EnesCanbolat/EE463-Project/An example of expected design.jpeg

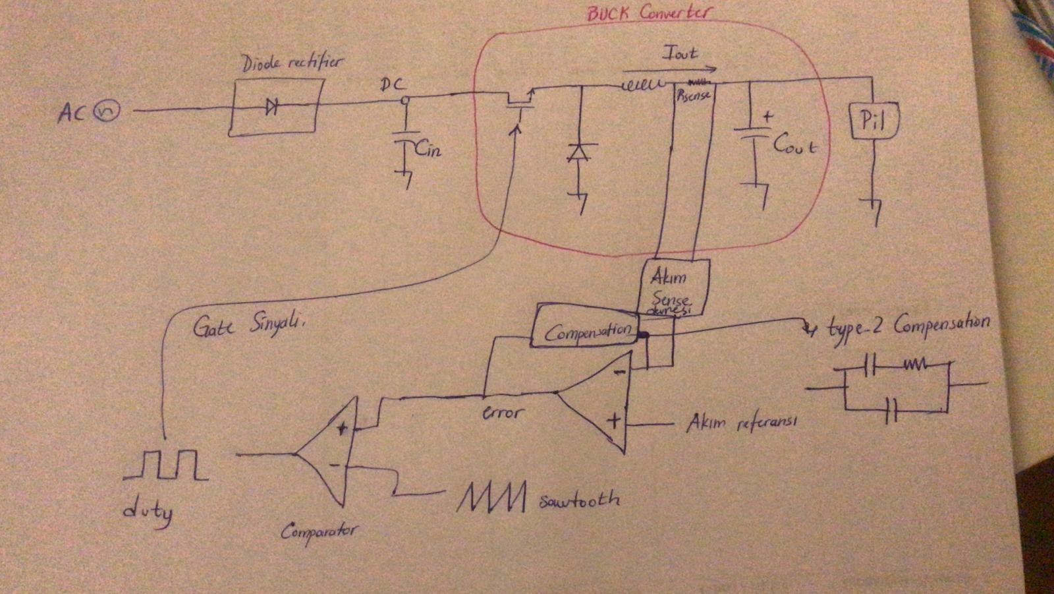
An example of expected design.jpeg
