EnesCanbolat/EE463-Project/pcb design/3D_1.JPG

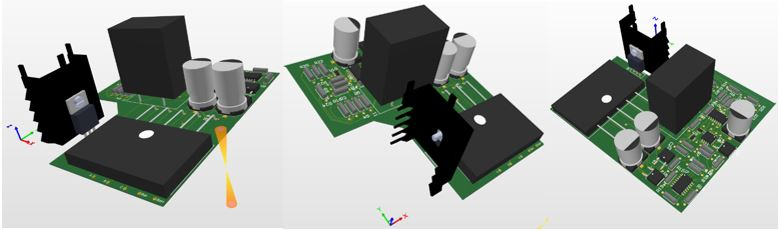
pcb design/3D_1.JPG
