EnesCanbolat/EE463-Project/Report Versions/EE463_Term_Project_Report_Kardesler_Elektronik_Berkay_Emin_Enes.docx

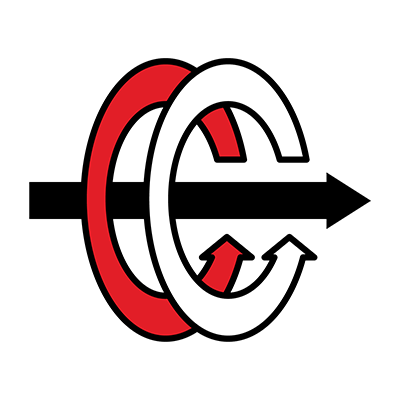
[picture p5: figure]

MIDDLE EAST TECHNICAL UNIVERSITY

ELECTRICAL & ELECTRONICS ENGINEERING

EE463 – STATIC POWER CONVERSION 1

TERM PROJECT – COMPLETE SIMULATION REPORT

Emin ÜN 2167476

Enes CANBOLAT 2231546

Berkay UZUN 2263812

25.12.2020

# 1- INTRODUCTION

Renewable energy is defined as useful energy collected from renewable resources. The wind is one of the renewable resources. It is used to provide mechanical power to the wind turbines to generate electricity. Wind power is widely used in sustainable energy. However, there are some problems with using the electricity produced in wind turbines. These turbines, generally, behave like an electric generator with a continuously varying output voltage and output current. In this project, Kardesler Elektronik A.Ş. introduces AC to the DC Converter project which regulates the output current. In the first part of this report, the topology of the converter will be discussed. The advantages and disadvantages of different topologies will be compared. Moreover, the reason for the topology selection will be given. In the second part, the circuit schematic and its simulation results with ideal cases will be provided. Moreover, the component selection and cost analysis will be provided in the second part. To conclude, our engineering skills in circuit design, simulations, and our project management skills will improve. Additionally, this project will give us an opportunity to implement the theoretical knowledge of us on EE463 lecture.

# 2- TOPOLOGY SELECTION

As mentioned in the 'Introduction' section, the generated voltage needs to be rectified to feed the given battery. To do this rectification, there are some topologies that can be used. Using a 3-phase thyristor rectifier and the diode rectifier with a buck converter are the most common ones. In this project, we preferred the diode rectifier with a buck converter topology because of some reasons. Firstly, controlled the thyristors considering their phase difference is not an easy job; however, the diode rectifier does not need any gate voltage and operates without any external intervention. On the other hand, we need to control the gate voltage of the MOSFET and hence the duty cycle of the buck converter to keep the output current the same. For this operation, again there is no one solution, using integrated circuits (IC) is one of the alternative solutions; however, the operating conditions are very important for these ICs. As shown in the 'Simulation Results' section, the input voltage varies, and this high voltage can damage the selected IC. That's why we preferred to control the gate signal of the MOSFET with an analog circuit design. Moreover, we wanted to observe the feedback operation step by step. If we used an integrated circuit, we would not be able to observe the entire circuit. Due to missing IC models in MATLAB and the modeling problem of input generator and battery in other simulation applications, we wouldn't be able to examine the performance of the design. Because of the pandemic conditions, we have also no chance to physically work on the designed circuit in the laboratory. Considering all these reasons, we decided to design an analog PI controller circuit. The last thing, we need to feed the gate of the MOSFET and hence we used one of the most common PWM generators called 555timer which can also be modeled in MATLAB Simulink. In short, we chose diode rectifiers with a buck converter topology and designed a closed-loop PI feedback controller without using any integrated circuit. In the following section, circuit blocks will be examined in detail and the simulation results will be shown.

# 3- CIRCUIT ANALYSIS & SIMULATION RESULTS

As mentioned before, our circuit design includes some parts and in this section, these blocks are examined in detail. In Figure 1, the block diagram of the circuit design is visualized.

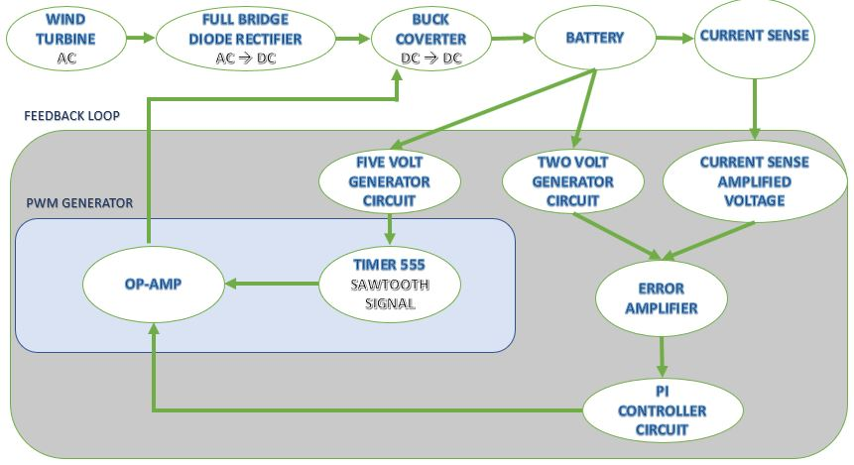
[picture p6: figure]

Figure 1 Block Diagram of the Circuit Design

## 3.1 Diode Rectifier and Buck Converter Block

As we learned in our lectures, a 3-phase diode rectifier is a good method to rectify the given AC signal; however, it is not enough to feed the battery without any external component since the output of the rectifier depends on the input voltage and it is affected by the changes in the input voltages. In the following Figure 2, the input voltage waveforms of the rectifier are illustrated.

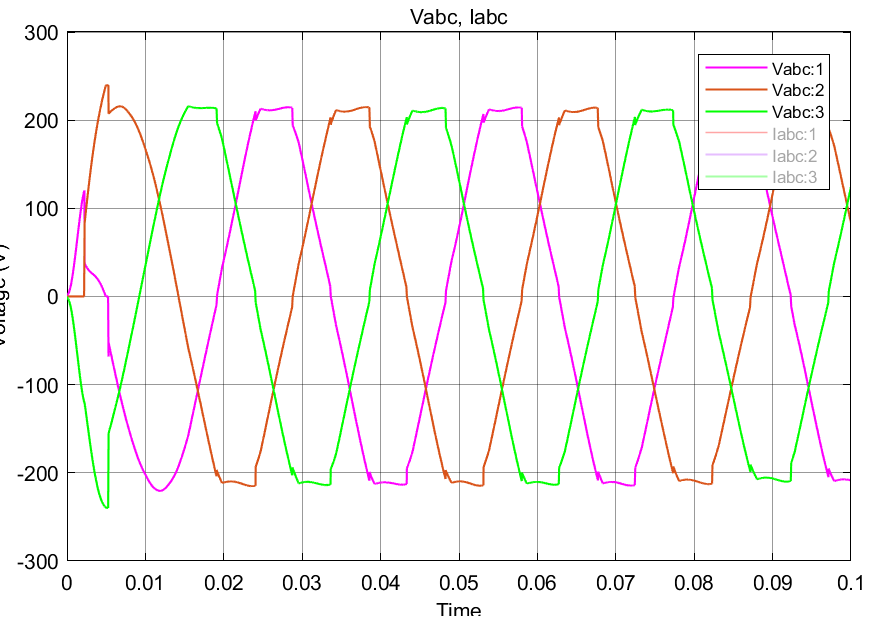
[picture p7: figure]

Figure 2 Input Voltage Waveforms of Diode Rectifier

The output voltage waveform is not a pure DC signal, in other words, the voltage ripple is very high on this waveform. Therefore, we used a shunt capacitor (100µF) to filter this signal. Then, we connected this output to the MOSFET of the buck converter. For the buck converter design 15mH inductor and 100µF capacitor are used. In the following Figure 3, this block of the design is shown, also in the next figure the input currents of the diodes are shown. These current values are important while selecting the proper diode.

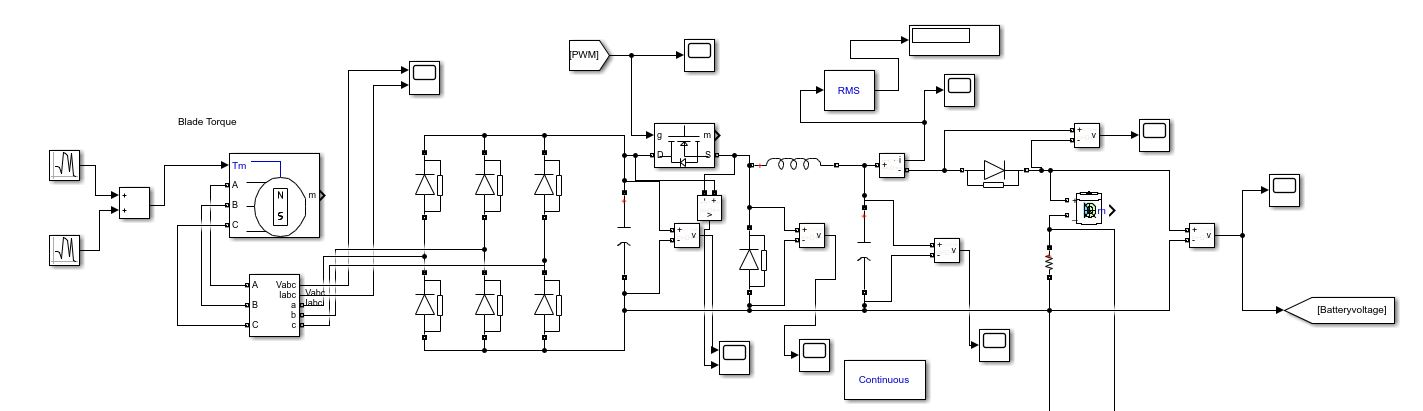
[picture p8: figure]

Figure 3 Diode Rectifier and Buck Converter Block

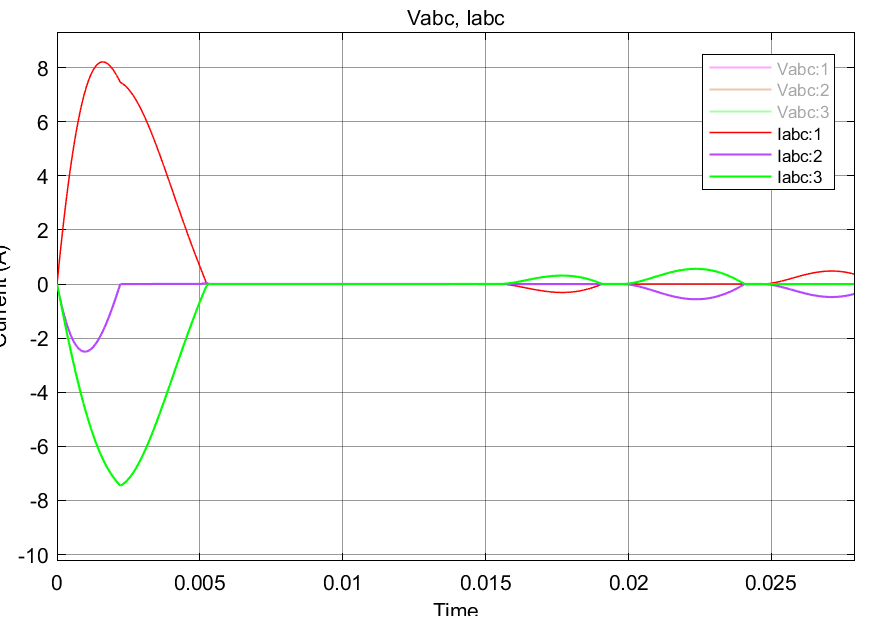
[picture p9: figure]

Figure 4 Input Current Waveforms of Diodes

## 3.2 Current Sense and Amplifier Block

In the project description, the input current value of the battery is given as a constant 2A and the ripple limit is 20% of the average current which is also specified in this description. Not to exceed this limit we connected a small resistor (250mΩ) to the negative leg of the battery. By checking the voltage on this resistor, we can understand the current flow through the resistor and hence the battery, and using this knowledge we can start our feedback loop; however, the resistance and current values are not high enough to decide the error. Therefore, we amplified this voltage value up to 3V and this block and this amplified voltage are shown in Figure 5 and Figure 6, respectively.

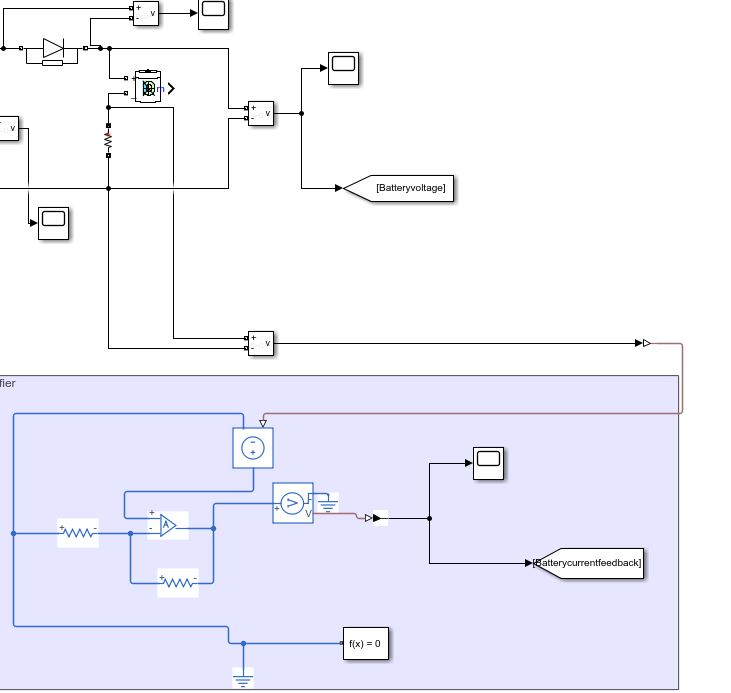
[picture p10: figure]

Figure 5 Current Sense and Amplifier Block

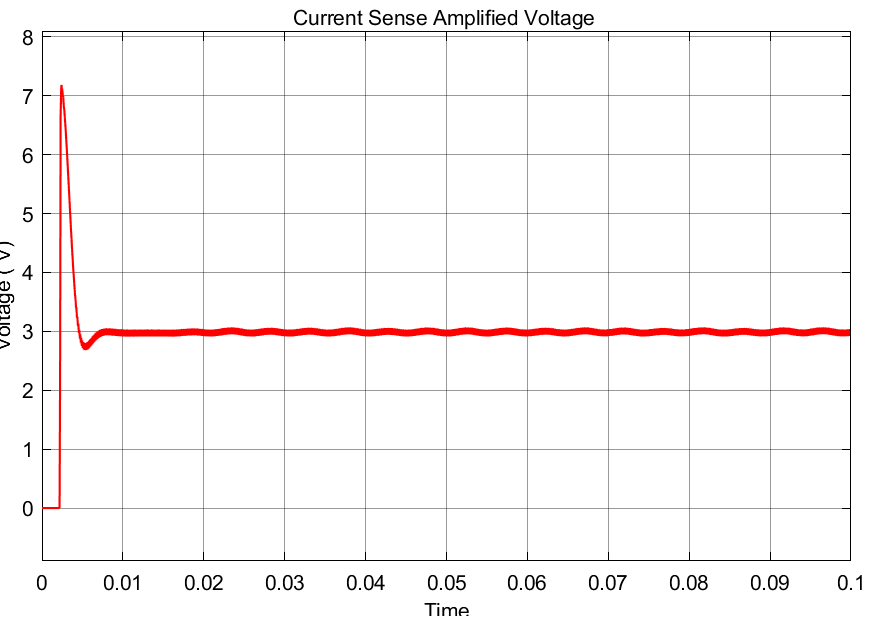
[picture p11: figure]

Figure 6 Waveform of Current Sense Amplified Voltage

## 3.3 DC Voltage Generator Block

In this design, we need to use DC voltages in some parts of the circuit such as feeding op-amps, the input of error amplifier, and input of 555timer component. Instead of using an external DC supply voltage, we use the battery input voltage. In the following Figure 7, the circuit schematic of this voltage generation block is shown. Note that, in this design, we need 2 and 5V values and their circuit schematic consist of two inverting amplifiers with different resistive values. In Figure 8 both 2V and 5V blocks' output values are shown.

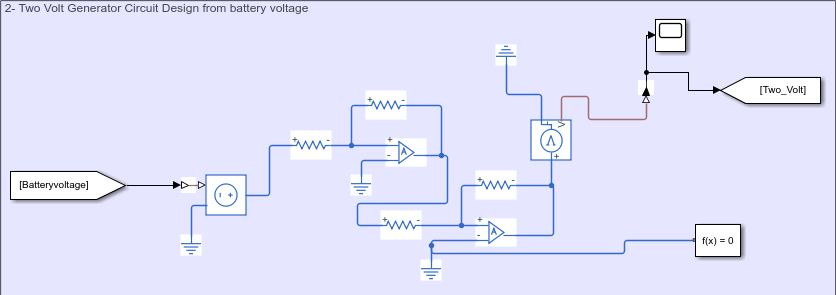
[picture p12: figure]

Figure 7 2 & 5V DC Generator Block

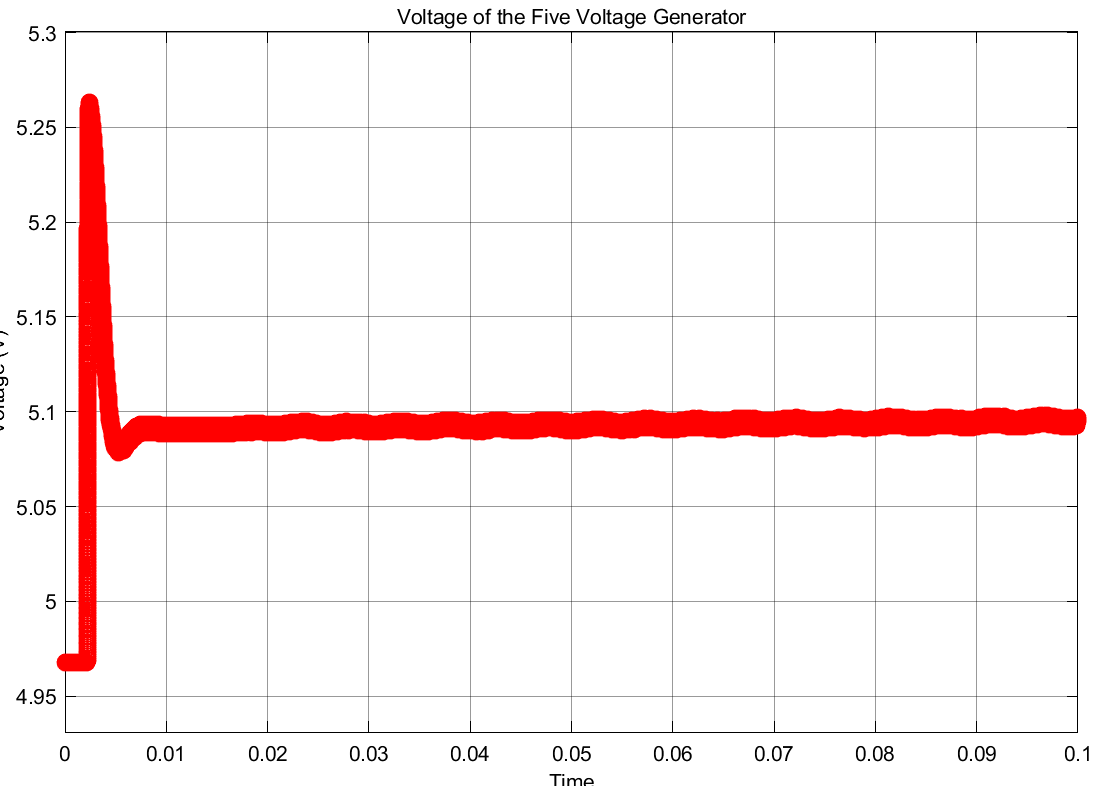
[picture p13: figure]
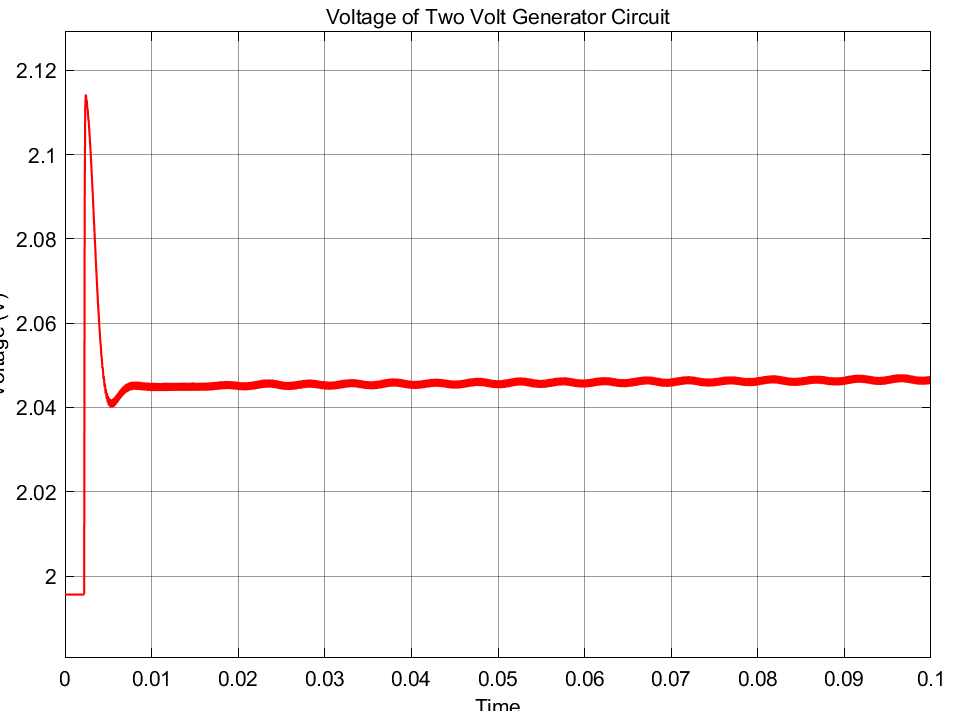
[picture p14: figure]

Figure 8 Output waveforms of 2- & 5-Volt Generation

## 3.4 Error Amplifier Block

In this part of the design, we found the error voltage using a differentiator circuit design. Using the 2 Volt DC and amplified current sense values, the difference between the (V+ & V-) input voltages of the op-amp is given as the output of this differentiator. Then, using this knowledge we can arrange the duty cycle of the buck converter. The positive error means that the current is lower than 2A and the duty cycle needs to be increased and if the negative error is observed, this time the current passing through the battery is higher than 2A and the duty cycle needs to be decreased in order to decrease the current value. The error amplifier block and the error signal can be shown in the following Figures 9 & 10, respectively.

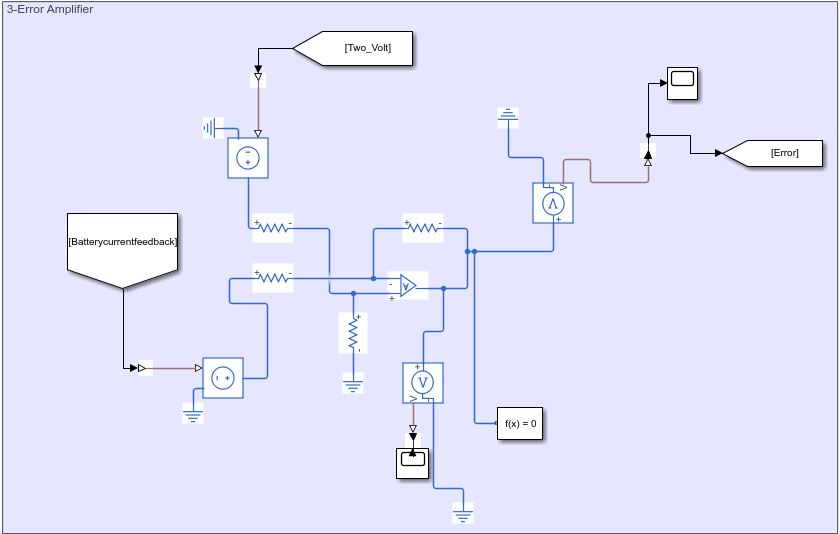
[picture p15: figure]

Figure 9 Error Amplifier Block

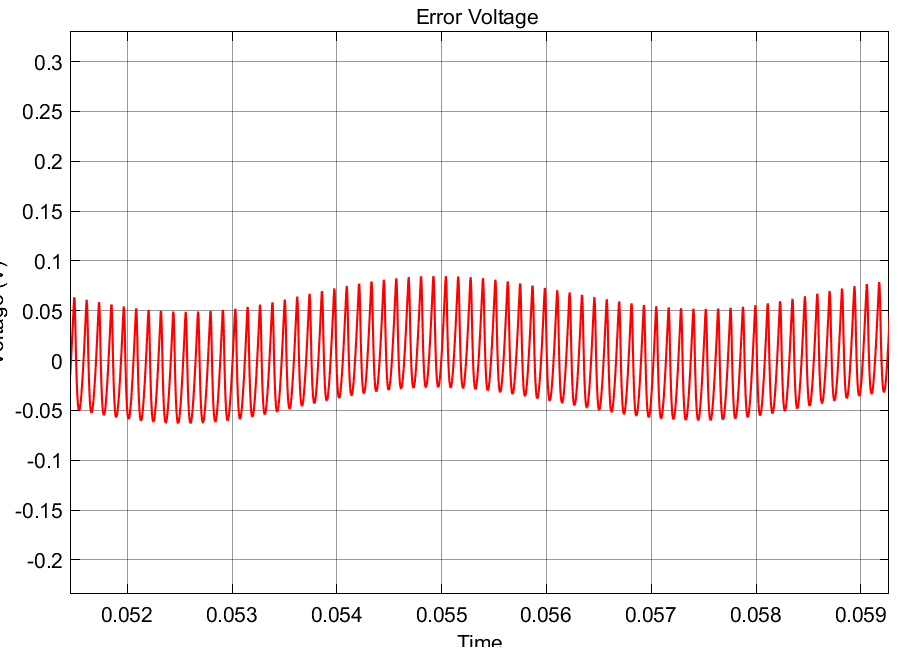
[picture p16: figure]
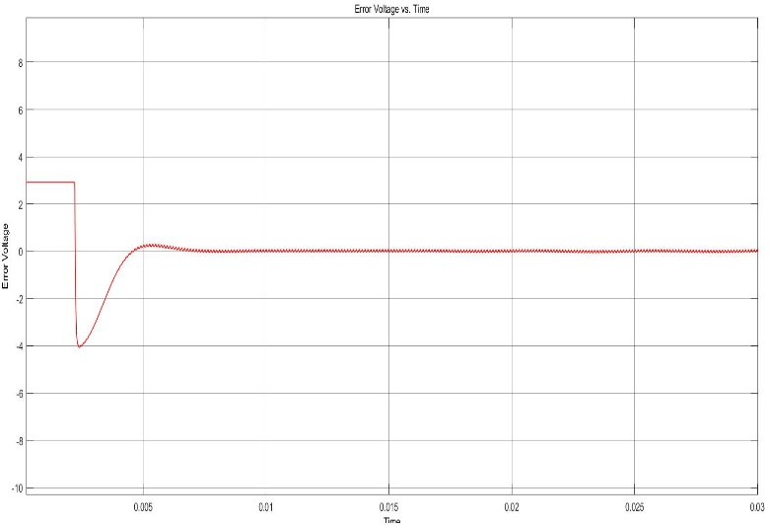
[picture p17: figure]

Figure 10 Error Voltage Waveform Before the Steady-State (Left Side) & Zoomed Version in the Steady-State (Right Side)

## 3.5 PI Controller Block

The aim of this block is to control the battery current using the error voltage which is explained in the previous section. As known, the transfer function of PI Controller is H(S)=K_p +(K_i)/s , and to create this transfer function we used 3 sub-circuits that are proportional, integrator, and summer. If it is necessary to explain briefly, the proportional part amplifies the error voltage and the ratio of two resistors in this part is the important parameter. The integrator block takes the integral of error voltage and multiplication of resistor and capacitor values are the important parameter for this block. Finally, the summer block sums these two values. The following Figure 11 shows the PI Controller block and the output waveform of this block can be seen in Figure 12.

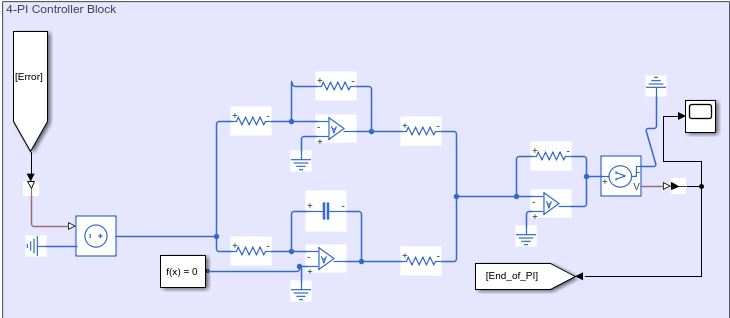
[picture p18: figure]

Figure 11 PI Controller Block

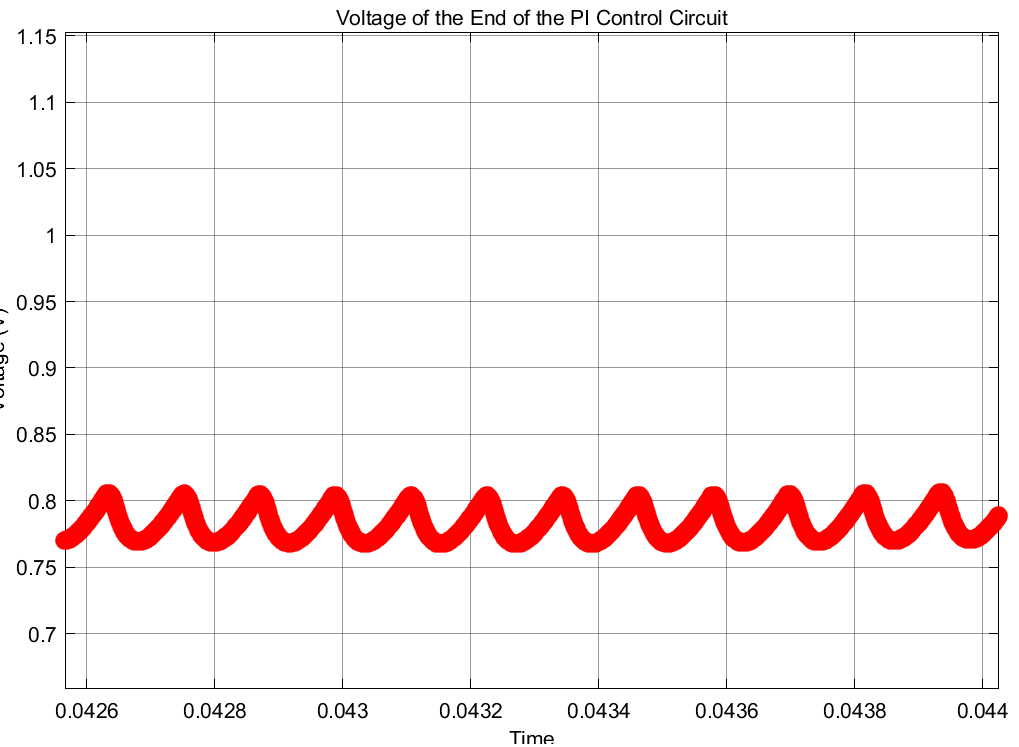
[picture p19: figure]
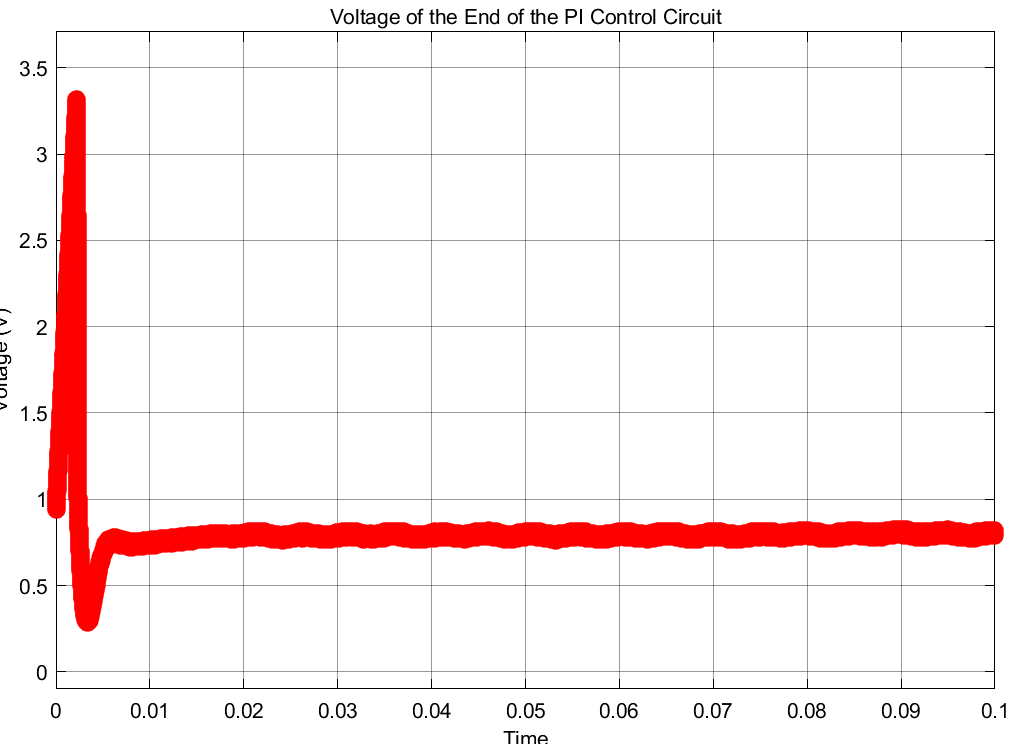
[picture p20: figure]

Figure 12 Output Voltage Waveform of the PI Controller Block (Zoomed Version is Shown in the Right Side)

## 3.6 PWM Generator Block

The last step of the feedback loop is generating the pulse voltage considering the output voltage of the PI Controller block. In this part, we used a common component called 555Timer and this creates the sawtooth signal. In order to activate this 555Timer device, we feed it with 5V which is mentioned in the previous sections of the report. Then using an op-amp, we can compare the output of the PI Controller, and this generated sawtooth voltage. After this comparison operation, the output is a form of a square wave, in other words, pulsating voltage waveform with changing duty cycle depending on the battery current. Both op-amp and Timer555 components create the PWM Generator block which is shown in the following Figure 13. Moreover, the output of this PWM generator can be seen in Figure 14. Note that, this voltage is directly connected with the gate of the MOSFET of the buck converter.

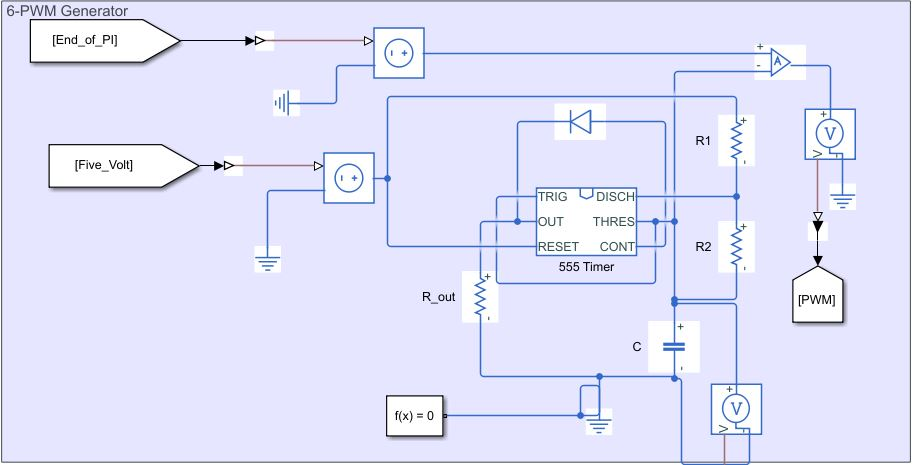
[picture p21: figure]

Figure 13 PWM Generator Block

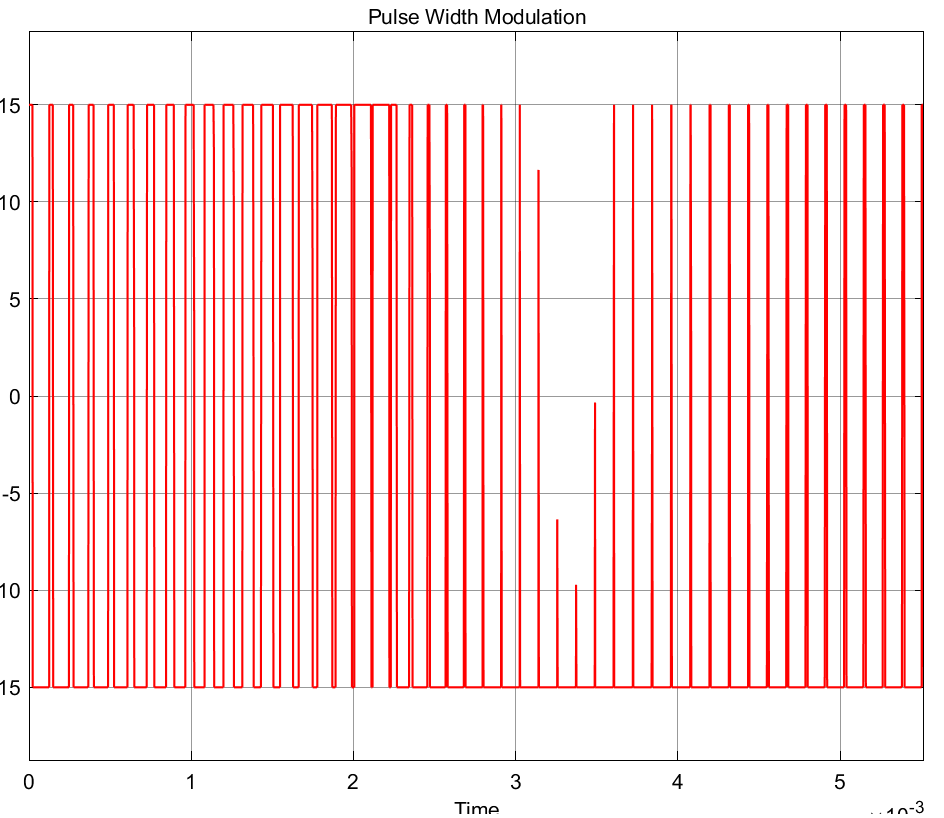
[picture p22: figure]

Figure 14 Input of the MOSFET's Gate

At the end of this feedback loop, we can get a 2.013 A average current which passes through the battery. The ripple on this current is about 5% of the average current. (It changes between 1.96 and 2.06A) In the following Figure 15, this battery current can be seen.

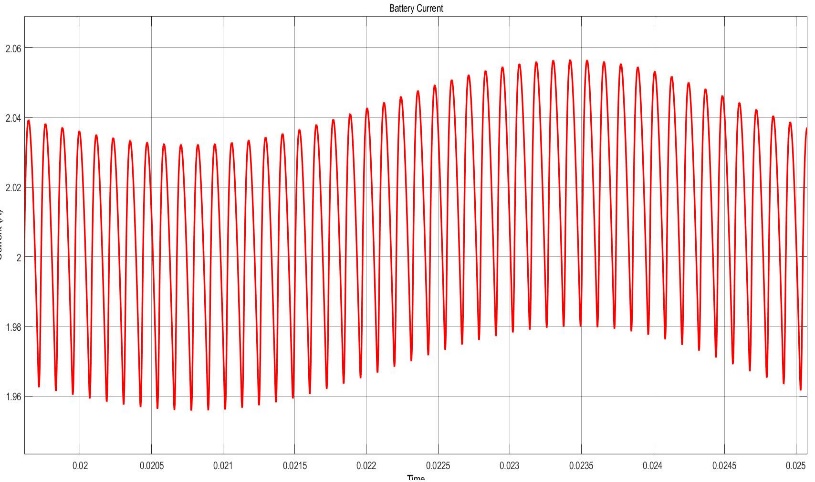
[picture p23: figure]
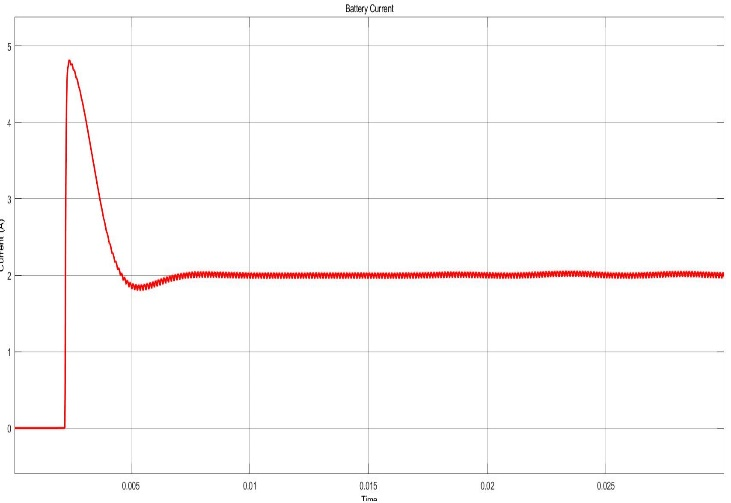
[picture p24: figure]

Figure 15 Waveform of the Battery Current (Zoomed Version is Shown in the Right Side)

# 4- COMPONENT SELECTION

There are many issues to be considered while selecting parameters. The parameters we choose may vary depending on the area we will use. In addition, since the parameter values of the component, we will select will vary, these parameters should also be considered. Each component has its parameters that we can consider the most important. When choosing components for our system, we have made the selection by evaluating the component types suitable for the area we will use based on parameters. We decided the parameter values according to the simulation results we got from the circuit we designed.

## 4.1Mosfet Selection

When choosing MOSFET, we made a selection by considering the maximum and rated values of voltage and current of our system. What we expect from the selected MOSFET is that it meets the following values. Considering these values, we chose N-Type MOSFET.

Table 1 shows the maximum and rated values of voltage and current of our system.

Table 1 Maximum and Rated Values of Voltage and Current of our system

| Rated Value | Max Value
Voltage (V) | 210 | 240
Current (A) | 2 | 5

## 4.2 Diode Selection

While choosing the diode, we determined the maximum voltage values of the diode I would choose by calculating the voltage of the diode in the circuit. We have diodes in 3 different places. The diodes we chose were selected to be used in the rectifier circuit, buck converter circuit, and before the battery. There are diodes specially designed for rectifier circuits. We made our choice by looking at the voltage rating. We calculated the voltage values of the diodes in the other two places with the help of Simulink and made the selection in that way. The diodes we selected are Schottky diodes.

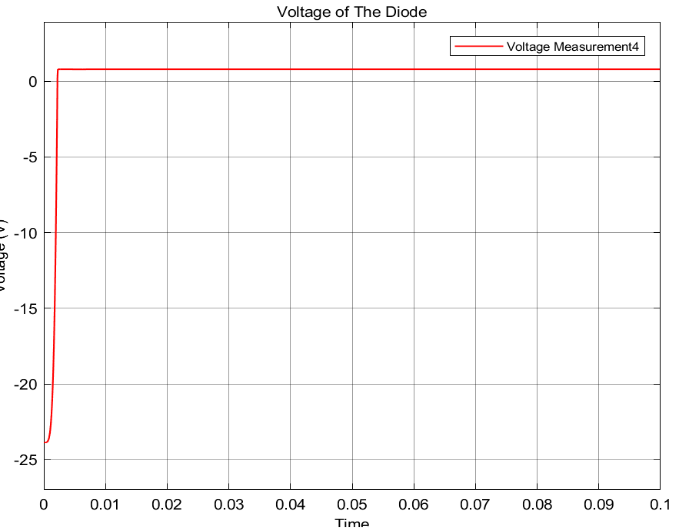
[picture p25: figure]

Figure 16 shows the voltage waveforms of diodes at the buck converter and before the battery respectively. The diode before the battery is used as a safety diode.

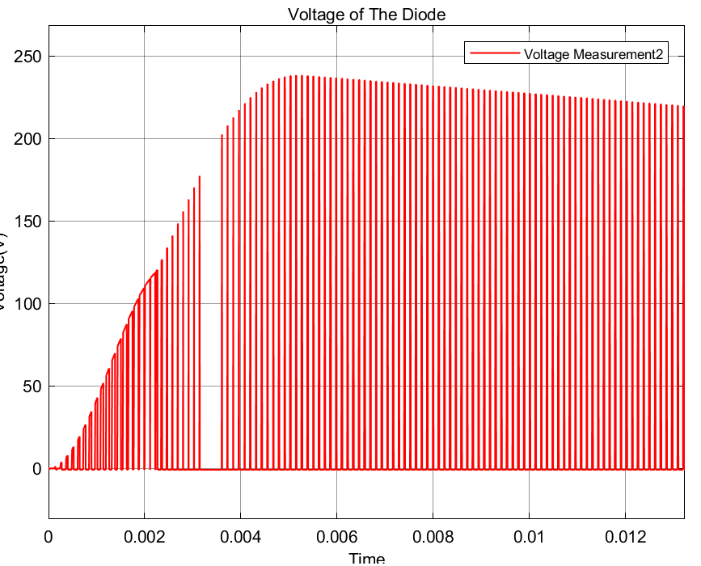
[picture p26: figure]

Figure 16 Voltage Waveforms of Diodes at the Buck Converter and Before the Battery Respectively

## 4.3 Capacitor Selection

While choosing capacitors, we calculated the voltage between capacitor terminals in the same way. Also, one of the other things to consider when choosing a capacitor is the size of the capacitor and its ripple factor. In addition to these, it is the endurance to current and voltage on the capacitor. Considering these, we made a capacitor selection. The capacitors we have selected are cheaper than others, the ripple factor is better. Also, their endurance performance is good enough and they have low ESR.

Figure 17 shows the voltage waveforms of the capacitors in our circuit. These capacitors were used at the output for filtering, a buck converter circuit, and TIMER 555 circuit for generating sawtooth signal respectively.

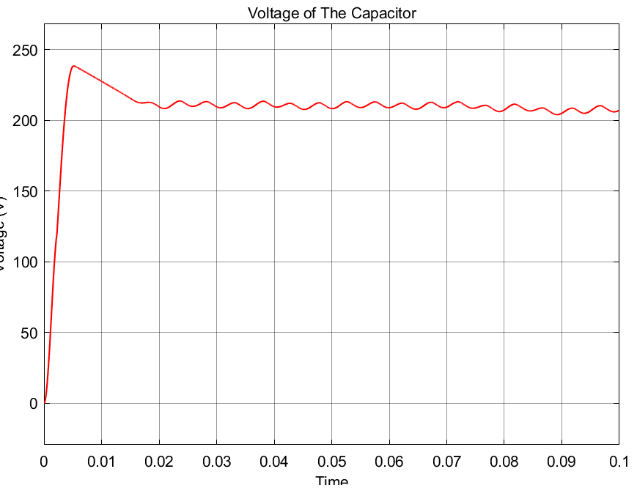
[picture p27: figure]
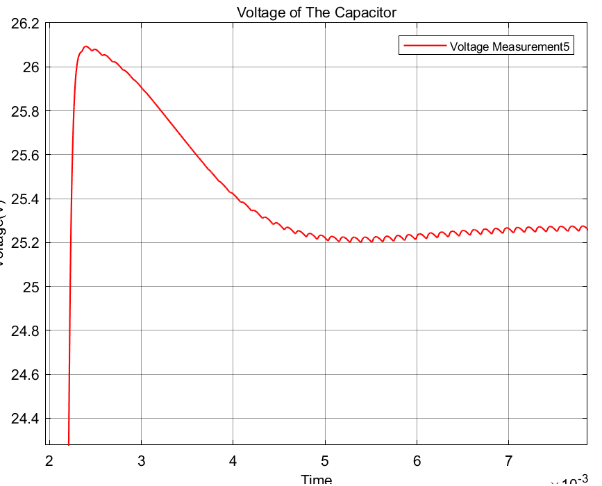
[picture p28: figure]
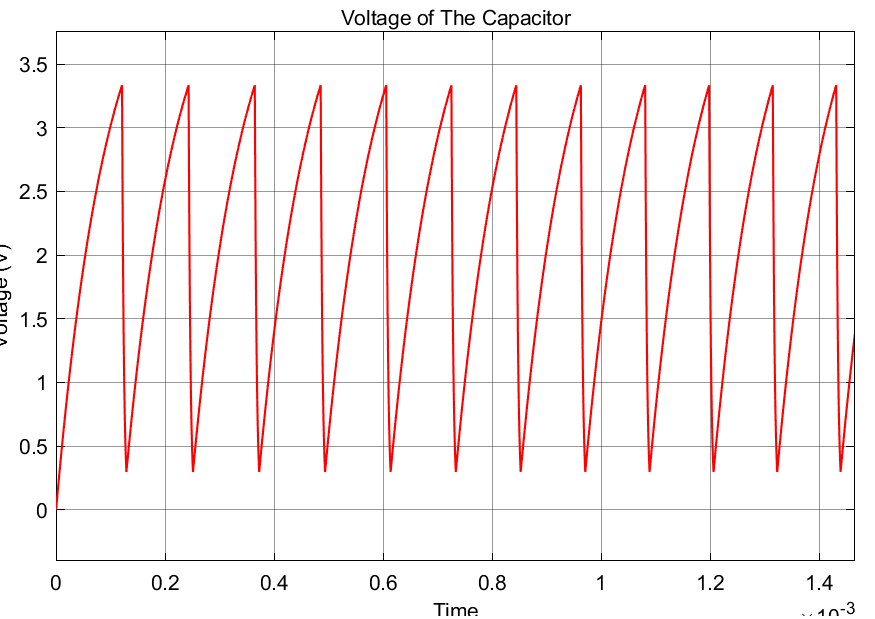
[picture p29: figure]

Figure 17 Voltage Waveforms of the Capacitors at Output, Buck Converter Circuit, and TIMER 555 Circuit Respectively.

## 4.4 Inductor Selection

While choosing the inductor, we made a selection considering the current flowing through it and the voltage value of the system. We also tried to choose a low cost of the inductor.

Figure 18 shows the current through the inductor. As can be seen from the graph, at first it takes a close order of 5A, but then it flows stably around 2A.

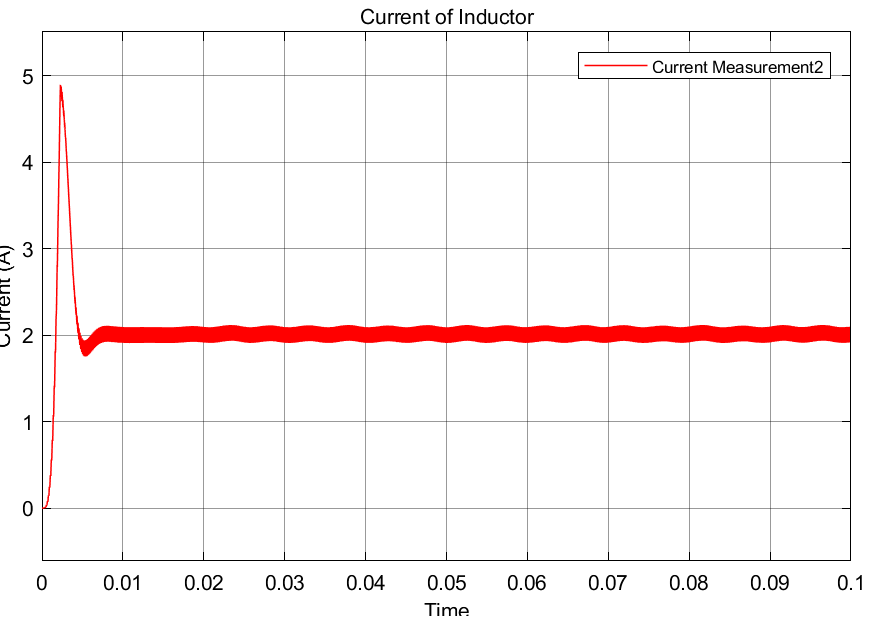
[picture p30: figure]

Figure 18 Current Waveform of the Inductor at the Buck Converter Circuit

## 4.5 Resistor Selection

One of the things we paid attention to when choosing a resistor was the material. Since the number of resistors in our circuit is high, we chose resistors made of a material with a low weight.

## 4.6 Op-Amp Selection

There are op-amps in 2 different regions in our circuit. One is in the main circuit; the others are in the feedback loop. While choosing op-amps in these places, we took into account the voltage values there. Our voltage value in the main circuit is too much compared to other places. For this reason, we have chosen an op-amp that has a higher endurance compared to the op-amps in the feedback loop.

According to these important points of view, Table 2 shows the component selection list with the cost analysis.

Table 2. Component Selection List with the Cost Analysis
Component | Rated Value | Place in the Circuit | Type of the Component | Manufacturer | Serial Number | Cost ($)
Resistors (Ω) | 0,25 | Current Sense | Chip Resistor - Surface Mount | Venkel | LCR0603-R250FT | 0.03062
| 1k | 2 Volt Generator | CARBON FILM RESISTOR | KOA Speer Electronics, Inc. | CF1/4C102J (https://www.digikey.com/en/products/detail/koa-speer-electronics-inc/CF1-4C102J/13537309) | 0.10000
| 5.1k | | CARBON FILM RESISTOR | KOA Speer Electronics, Inc. | CFS1/4CT52R512J | 0.10000
| | | CARBON FILM RESISTOR | KOA Speer Electronics, Inc. | CFS1/4CT52R512J | 0.10000
| 12k | | CARBON FILM RESISTOR | KOA Speer Electronics, Inc. | CF1/4CT52R123J | 0.10000
| 560 | 5 Volt Generator | CARBON FILM RESISTOR | KOA Speer Electronics, Inc. | CF1/2CT52R561J | 0.11000
| 2.7k | | CARBON FILM RESISTOR | KOA Speer Electronics, Inc. | CF1/2CT52R272J | 0.11000
| 5.1k | | CARBON FILM RESISTOR | KOA Speer Electronics, Inc. | CFS1/4CT52R512J | 0.10000
| | | CARBON FILM RESISTOR | KOA Speer Electronics, Inc. | CFS1/4CT52R512J | 0.10000
| 240 | Amplifier | CARBON FILM RESISTOR | KOA Speer Electronics, Inc. | CF1/2CT52R241J | 0.11000
| 1.2k | | CARBON FILM RESISTOR | KOA Speer Electronics, Inc. | CF1/4CT52R122J | 0.10000
| 1.2k | Error Amplifier | CARBON FILM RESISTOR | KOA Speer Electronics, Inc. | CF1/4CT52R122J | 0.10000
| 3.3k | | CARBON FILM RESISTOR | KOA Speer Electronics, Inc. | CF1/4CT52R332J | 0.10000
| 5.1k | | CARBON FILM RESISTOR | KOA Speer Electronics, Inc. | CFS1/4CT52R512J | 0.10000
| | | CARBON FILM RESISTOR | KOA Speer Electronics, Inc. | CFS1/4CT52R512J | 0.10000
| 680 | PI Controller | CARBON FILM RESISTOR | KOA Speer Electronics, Inc. | CFS1/4CT52R681J | 0.10000
| 820 | | CARBON FILM RESISTOR | KOA Speer Electronics, Inc. | CF1/2CT52R821J | 0.11000
| | | CARBON FILM RESISTOR | KOA Speer Electronics, Inc. | CF1/2CT52R821J | 0.11000
| 2.2k | | CARBON FILM RESISTOR | KOA Speer Electronics, Inc. | CF1/2CT52R222J | 0.11000
| | | CARBON FILM RESISTOR | KOA Speer Electronics, Inc. | CF1/2CT52R222J | 0.11000
| 5.6k | | CARBON FILM RESISTOR | KOA Speer Electronics, Inc. | CF1/4CT52R562J | 0.10000
| 1.2k | Timer | CARBON FILM RESISTOR | KOA Speer Electronics, Inc. | CFS1/4CT52R122J | 0.10000
| 3.3k | | CARBON FILM RESISTOR | KOA Speer Electronics, Inc. | CF1/4CT52R332J | 0.10000
| 100k | | CARBON FILM RESISTOR | KOA Speer Electronics, Inc. | CF1/2CT52R104J | 0.11000
Capacitors | 100µF | Buck Converter | Aluminum Electrolytic | Illinois Capacitor | 107RZM05 | 0,02856
| 100µF | Filter | Aluminum Electrolytic | United Chemi-Con | EKXJ221ELL101MK25S (https://www.digikey.com/en/products/detail/united-chemi-con/EKXJ221ELL101MK25S/3528962) | 0,71258
| 1nF | Timer | Ceramic | Yageo | CC0100KRX5R4BB102 (https://www.digikey.com/en/products/detail/yageo/CC0100KRX5R4BB102/11490370) | 0,01475
Inductor | 15mH | Buck Converter | Fixed RING CORE CHOKE | EPCOS/TDK | 871-B82724J8302N040 | 5,9593
MOSFET | 240V (Max) 210V(Rated) 5A (Max) 2A (Rated) | Buck Converter | N-MOSFET | Infineon Technologies | 726-IPN70R360P7SAUMA | 0,92964
Diodes | | Rectifier | Bridge Rectifier | Micro Commercial Components | 833-3GBJ3516-BP | 5,4778
| | Buck Converter | Schottky Diode | Wolfspeed / Cree | 941-C6D04065E | 0,89914
| | Before the battery | Schottky Diode | Vishay General Semiconductor | 78-V8PAM10S-M3/H | 0,4026
| | Timer | IC OSC SINGLE TIMER | Texas Instruments | 296-1857-5-ND | 0,84
OP-AMP (11) | | Everywhere:) | Operational-Amplifier | NJR | 513-NJU7067M-TE2 | 1,62382
OP-AMP | | Current Sense | Operational-Amplifier | Texas Instruments | 595-OPA2990IDDFR | 1,6592
| | | | | Total Cost = | 18,54739

# 5- CONCLUSION

In this project, we aimed to regulate the output current of a wind turbine to charge a battery with constant voltage and constant current. In this report, the project and its processes are explained. First of all, topology selection is explained. After that, the circuit is analyzed, and its simulation results are provided with the components that are selected for the project. The cost analysis is provided for the component selection.

Starting with this early stage of the project, we have improved our engineering skills on circuit design and simulation and management skills with the cost analysis of the project. In conclusion, by implementing this project, we have improved our skills to use the theoretical knowledge from the EE463 course.
