EnesCanbolat/EE463-Project/DC_DC_Converter_design/1.pdf

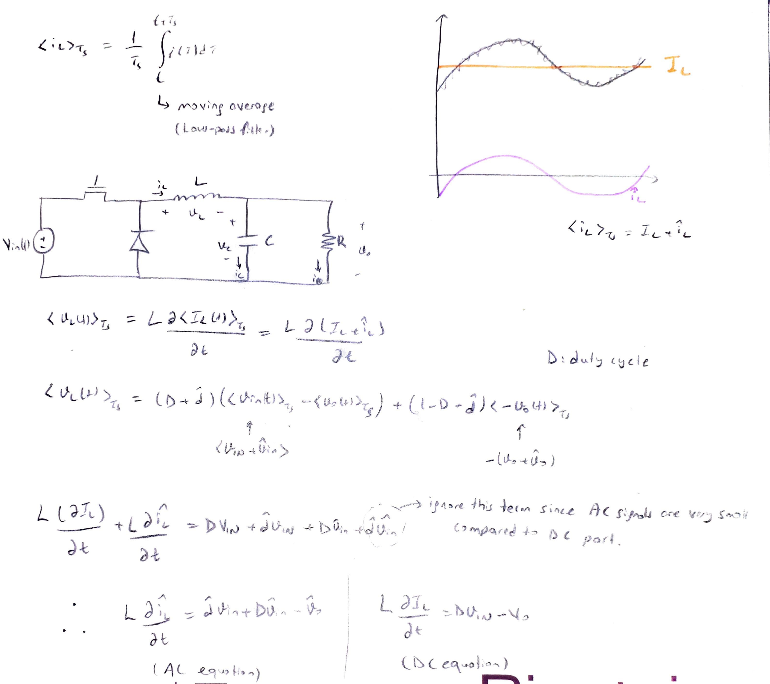
[picture p63: page 1]
