EnesCanbolat/EE463-Project/current values of input currents.png

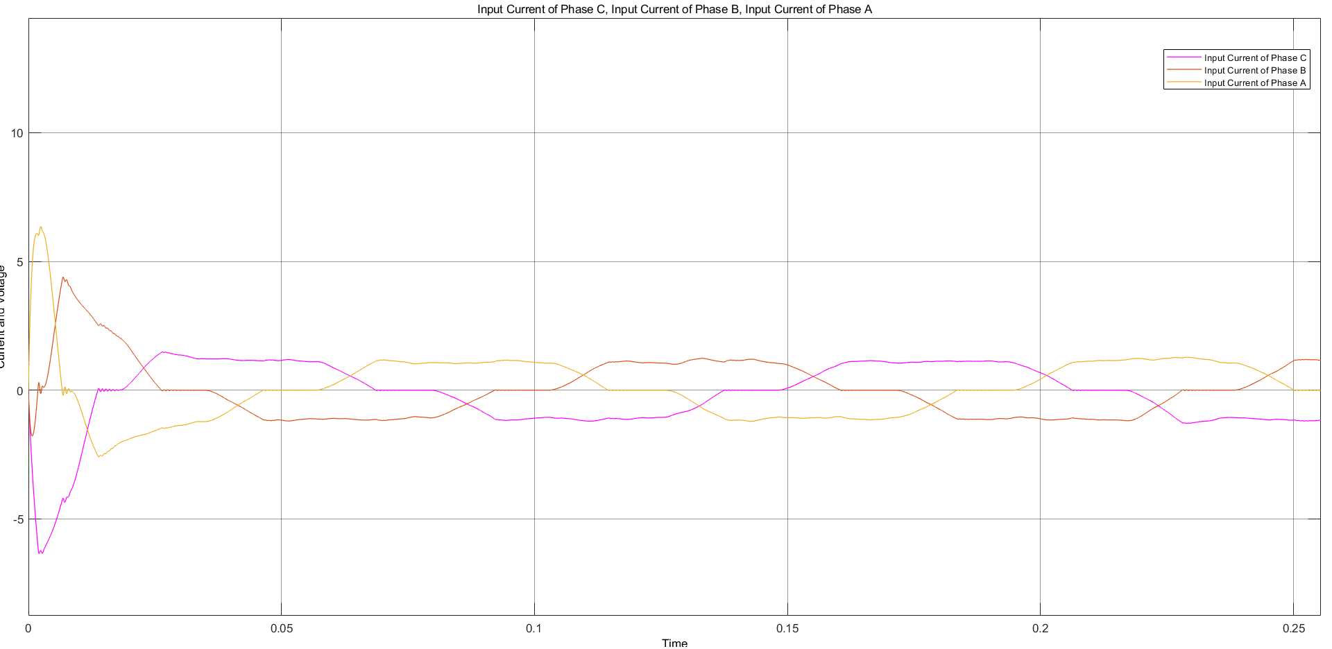
current values of input currents.png
