EnesCanbolat/EE463-Project/DC_DC_Converter_design/4.JPG

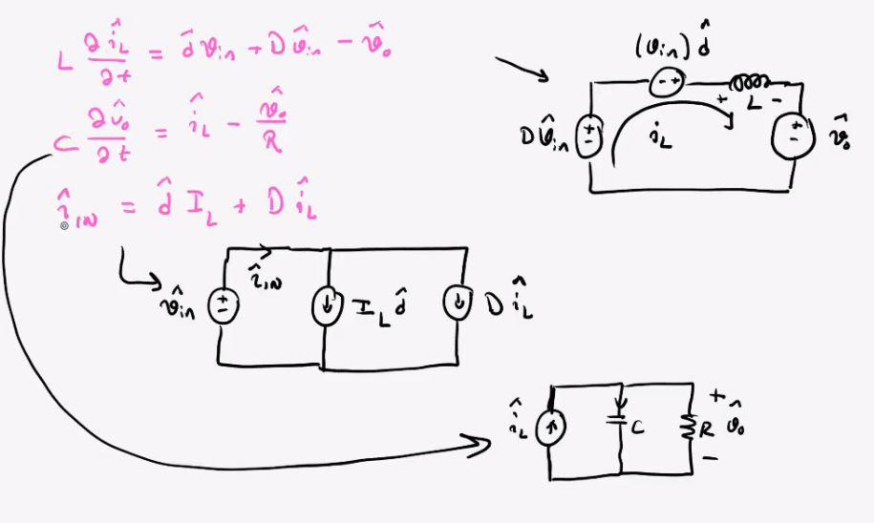
DC_DC_Converter_design/4.JPG
