EnesCanbolat/EE463-Project/DC_DC_Converter_design/6.JPG

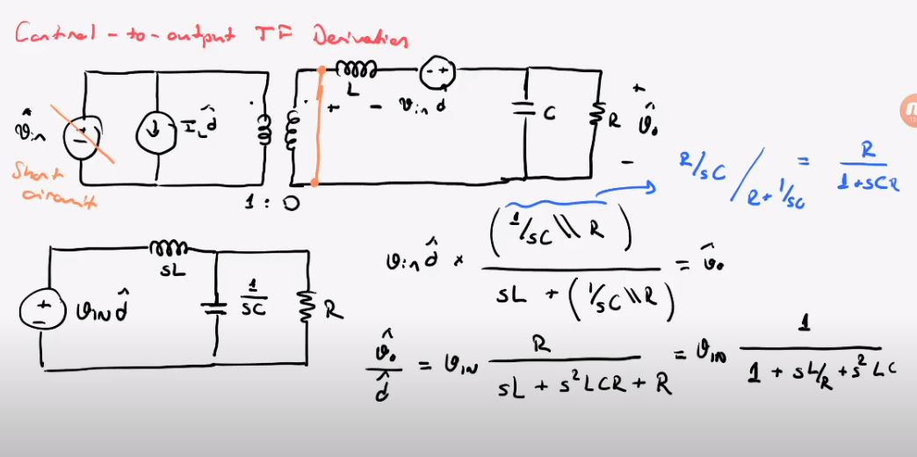
DC_DC_Converter_design/6.JPG
