EnesCanbolat/EE463-Project/DC_DC_Converter_design/9.JPG

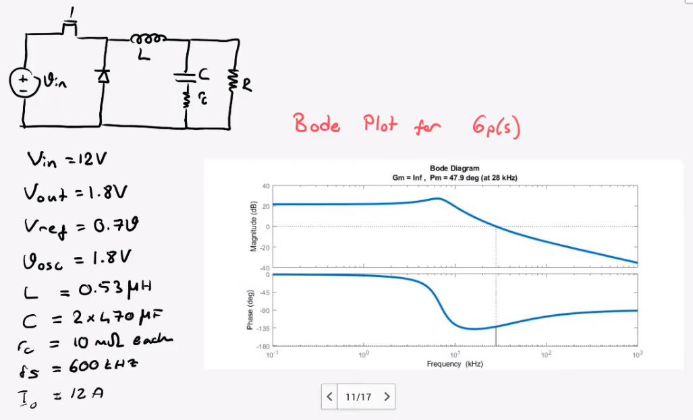
DC_DC_Converter_design/9.JPG
