EnesCanbolat/EE463-Project/DC_DC_Converter_design/10.JPG

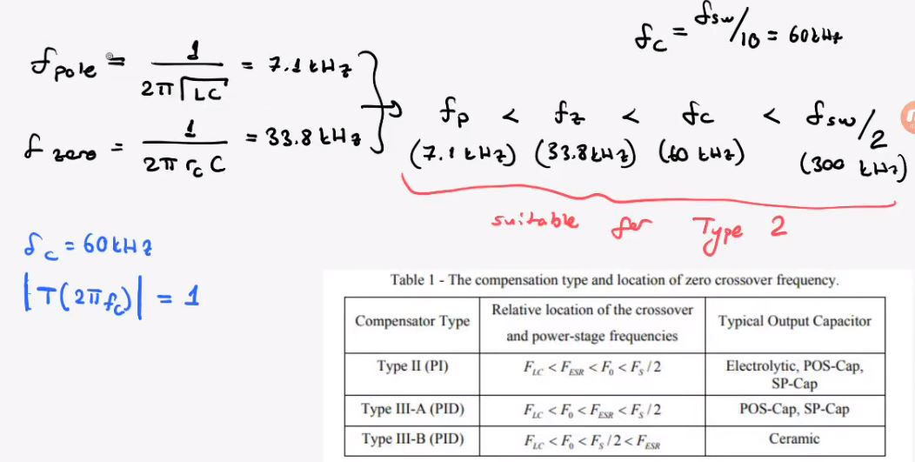
DC_DC_Converter_design/10.JPG
