EnesCanbolat/EE463-Project/DC_DC_Converter_design/15.JPG

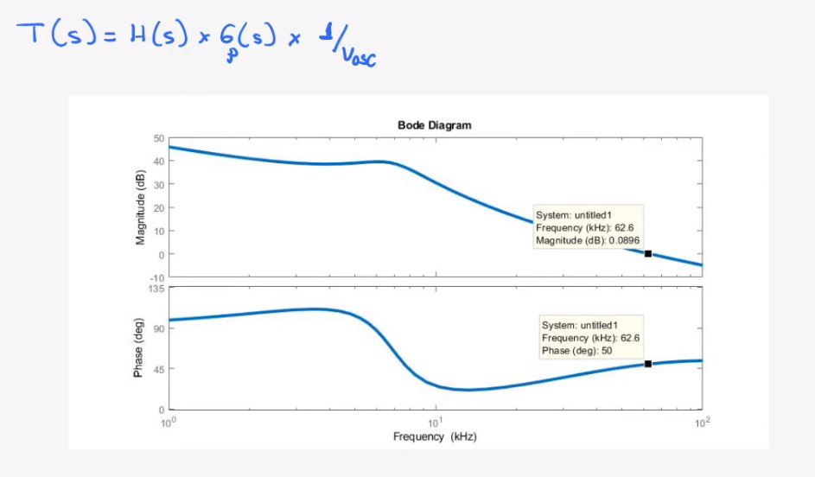
DC_DC_Converter_design/15.JPG
