EnesCanbolat/EE463-Project/FINAL VERSIONS/1/Simulation/Voltage of The Capacitor 2.png

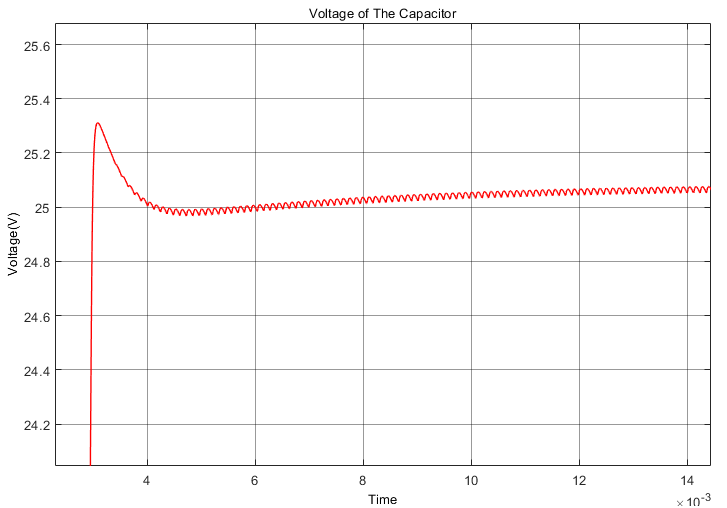
FINAL VERSIONS/1/Simulation/Voltage of The Capacitor 2.png
