EnesCanbolat/EE463-Project/FINAL VERSIONS/1/Simulation/Voltage of The First Diode.png

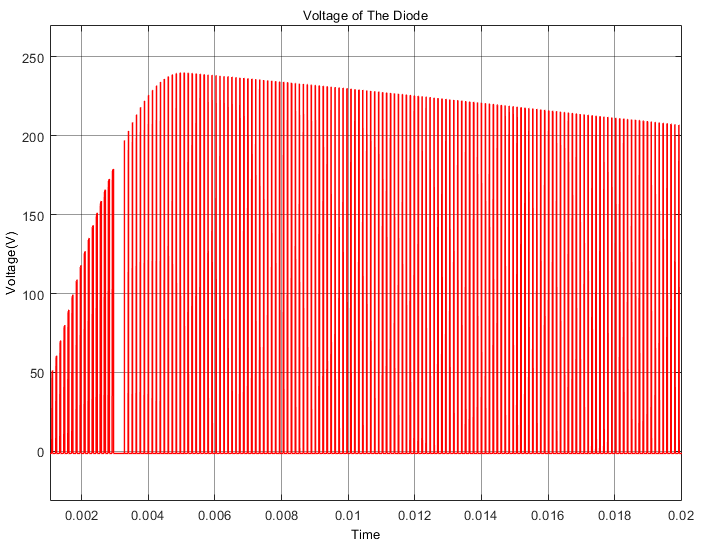
FINAL VERSIONS/1/Simulation/Voltage of The First Diode.png
