EnesCanbolat/EE463-Project/output of diode rectifier.png

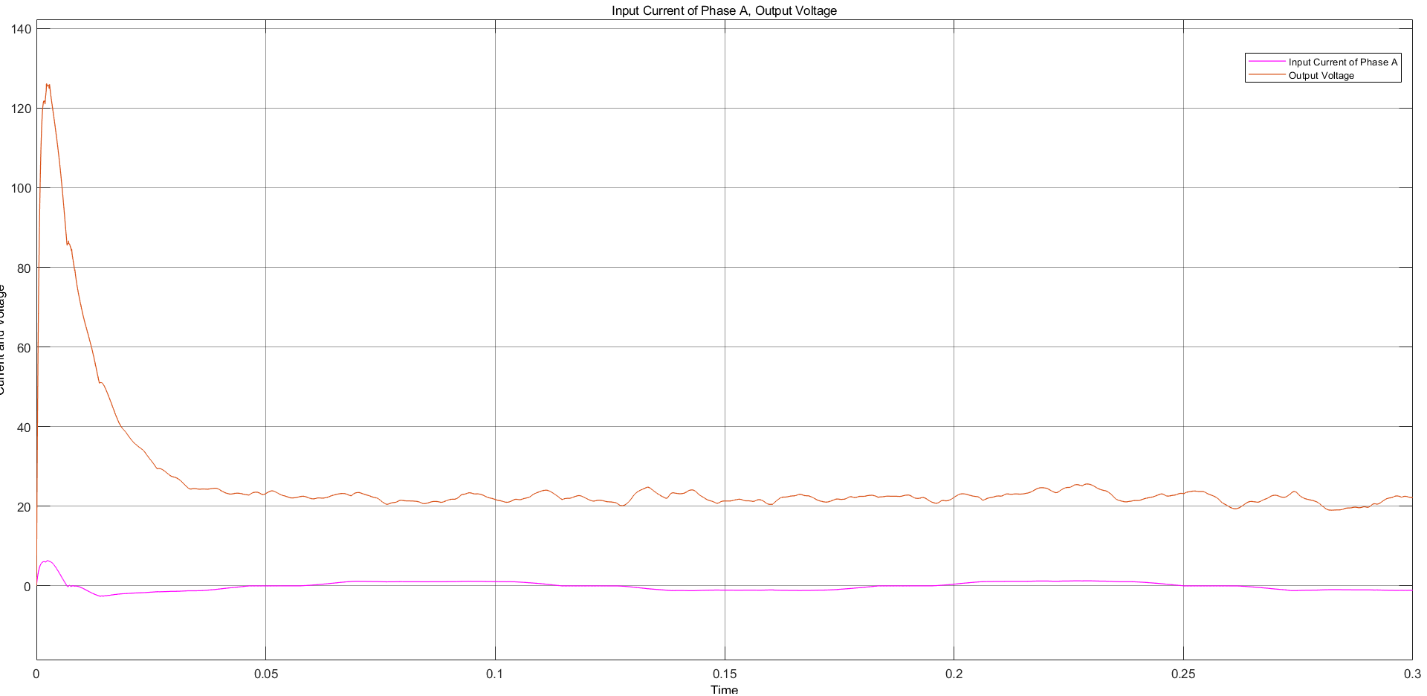
output of diode rectifier.png
