EnesCanbolat/EE463-Project/pcb design/3d1.PNG

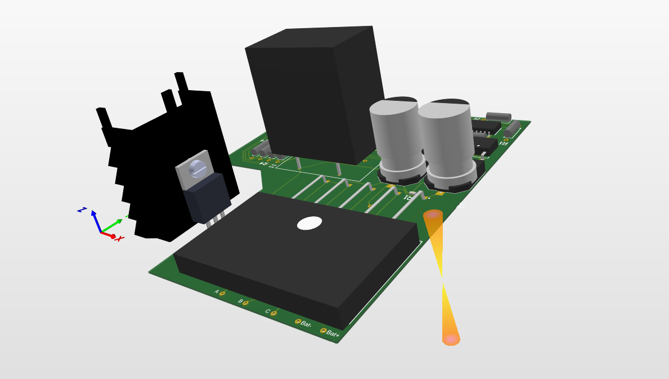
pcb design/3d1.PNG
