EnesCanbolat/EE463-Project/pcb design/3d2.PNG

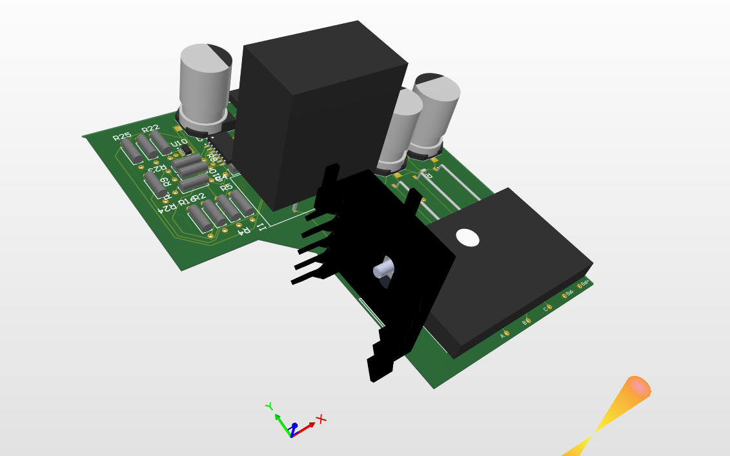
pcb design/3d2.PNG
