EnesCanbolat/EE463-Project/pcb design/3d3.PNG

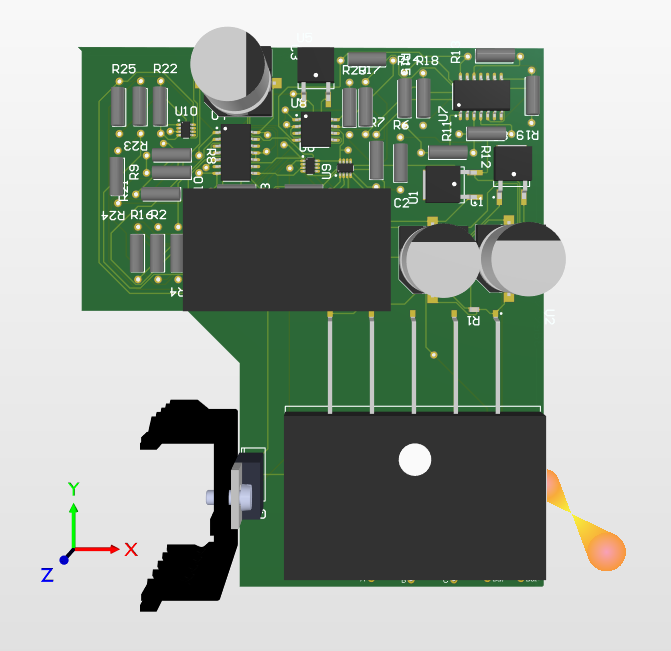
pcb design/3d3.PNG
