EnesCanbolat/EE463-Project/pcb design/3d4.PNG

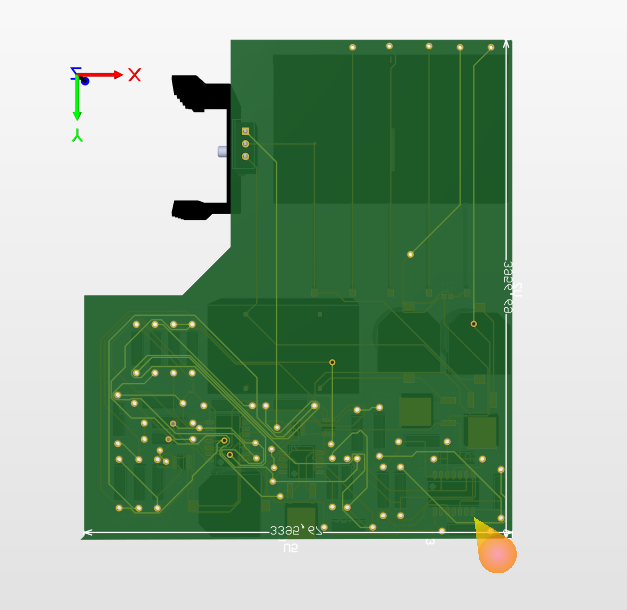
pcb design/3d4.PNG
