EnesCanbolat/EE463-Project/pcb design/3d5.PNG

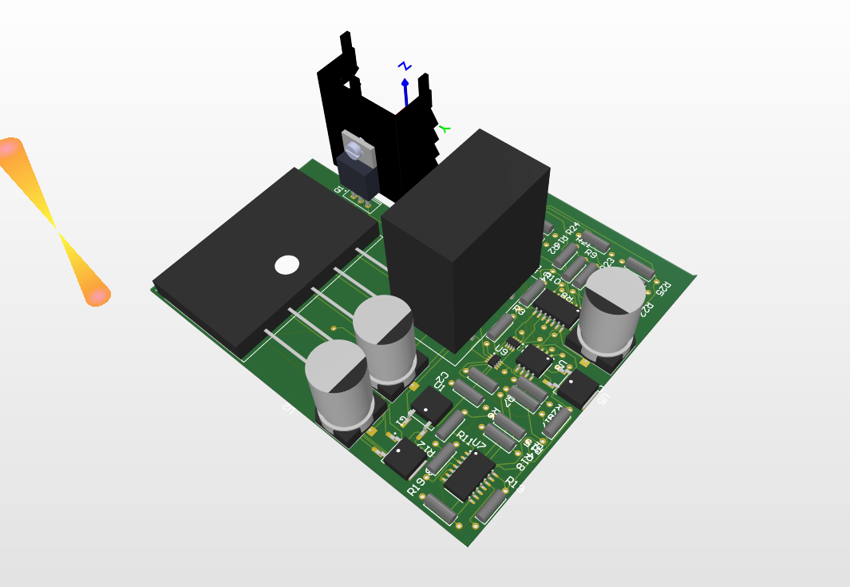
pcb design/3d5.PNG
