EnesCanbolat/EE463-Project/pcb design/pcb2d.PNG

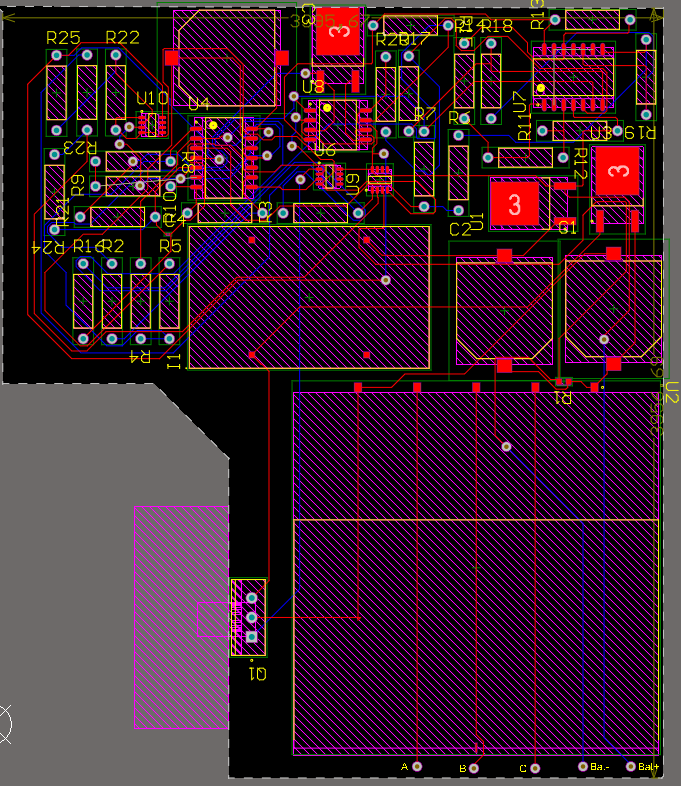
pcb design/pcb2d.PNG
