EnesCanbolat/EE463-Project/Term Project/Schematic of Our Design Circuit.JPG

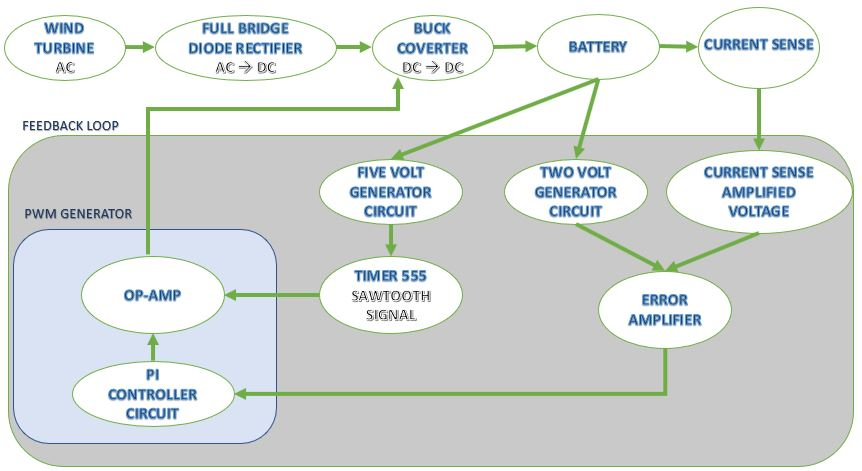
Term Project/Schematic of Our Design Circuit.JPG
