EnesCanbolat/EE463-Project/Term Project/Simulation/Battery Current Zoomed Version.jpg

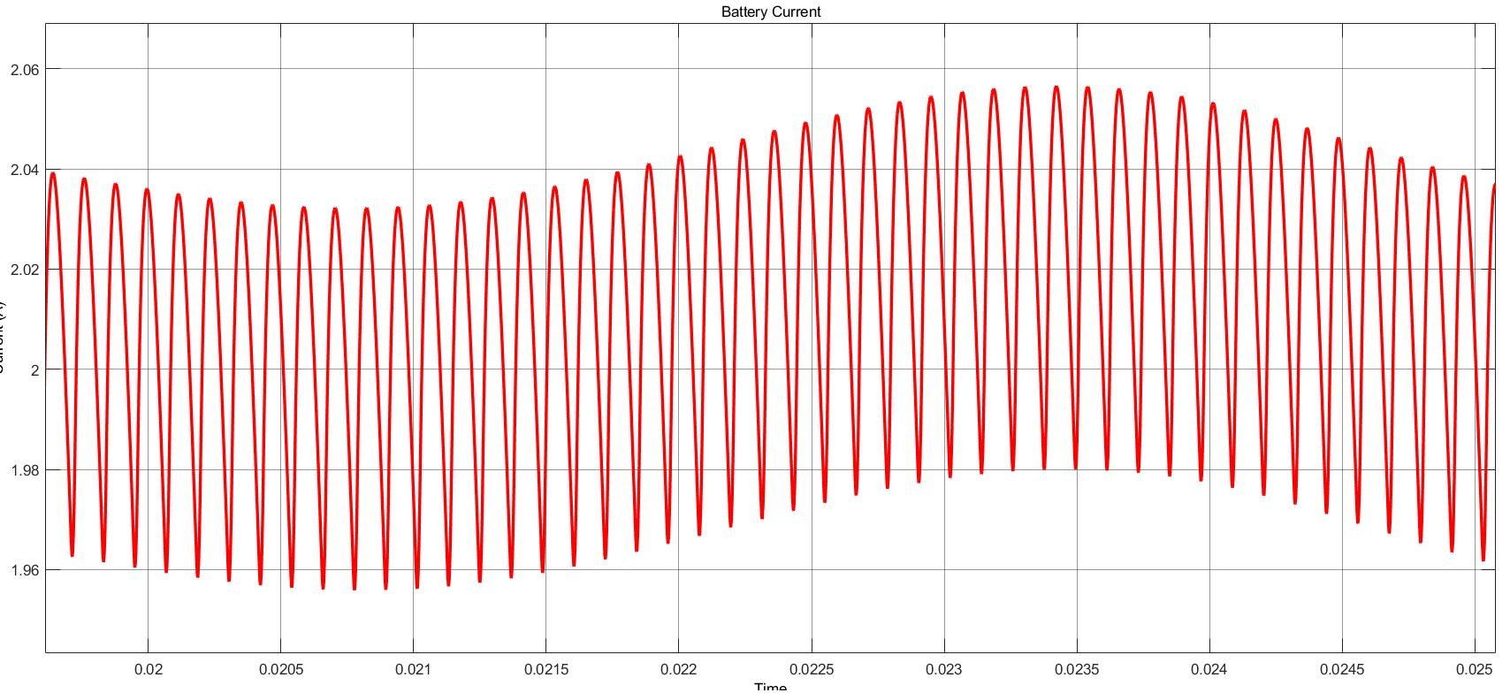
Term Project/Simulation/Battery Current Zoomed Version.jpg
