EnesCanbolat/EE463-Project/Term Project/Simulation/Battery Current.jpg

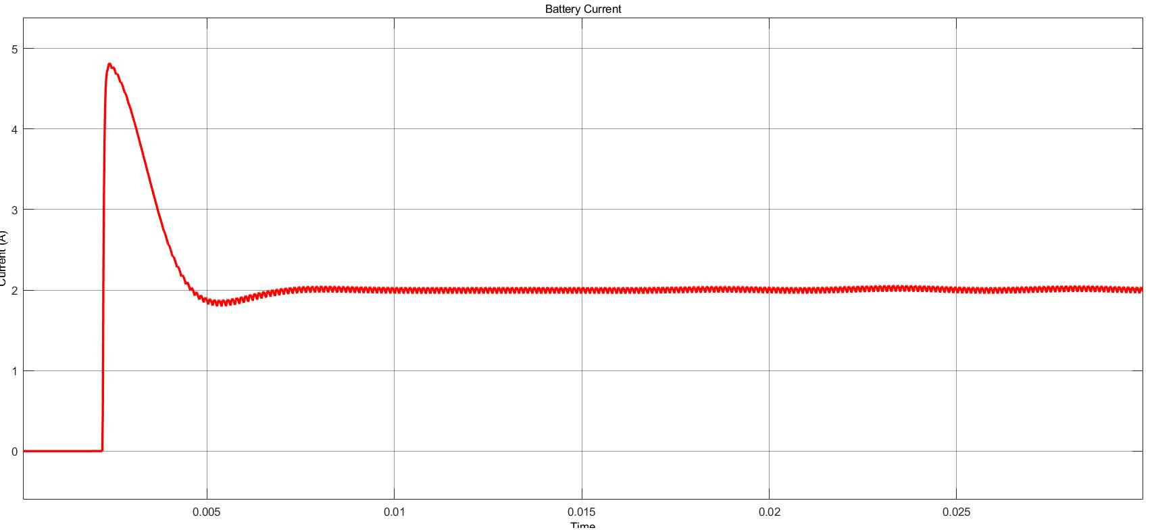
Term Project/Simulation/Battery Current.jpg
