EnesCanbolat/EE463-Project/Term Project/Simulation/Error Voltage.jpg

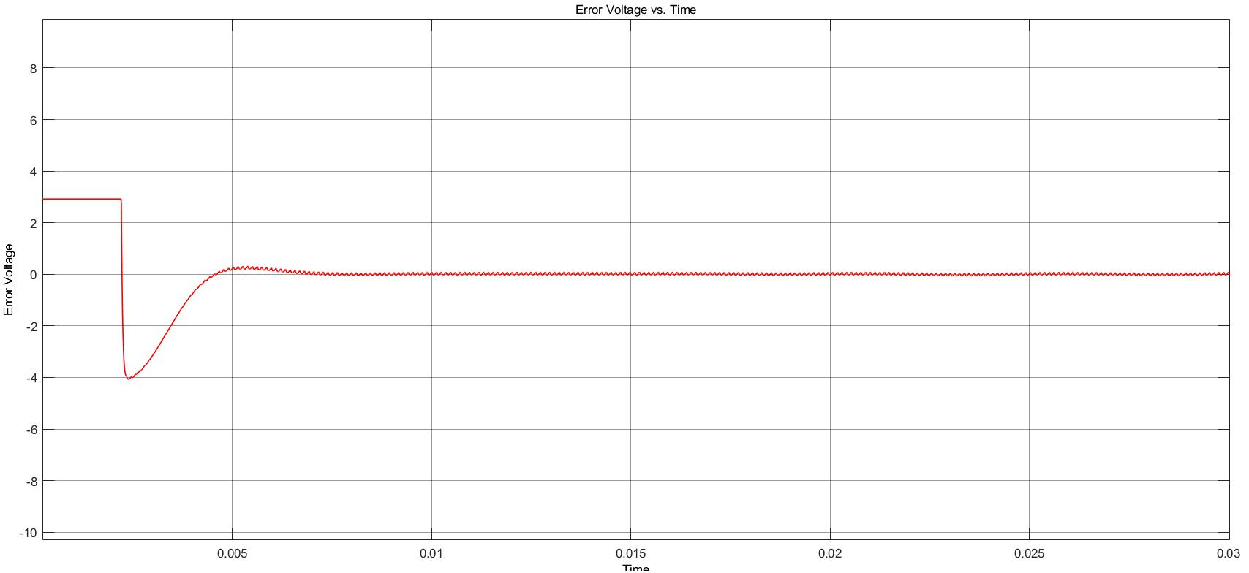
Term Project/Simulation/Error Voltage.jpg
