EnesCanbolat/EE463-Project/Component Selection/Component List.v5.xlsx

Sheet: Sayfa1
Component | Rated Value | Place in the Circuit | Type of the Component | Manufacturer | Serial Number | Cost ($) | Website
Resistors (Ω) | 0.25 | Current Sense | Chip Resistor - Surface Mount | Venkel | LCR0603-R250FT | 0.03062 | https://www.digikey.com/en/products/detail/venkel/LCR0603-R250FT/12333391
 | 1k | 2 Volt Generator | CARBON FILM RESISTOR | KOA Speer Electronics, Inc. | CF1/4C102J (https://www.digikey.com/en/products/detail/koa-speer-electronics-inc/CF1-4C102J/13537309) | 0.10000 | https://www.digikey.com/en/products/detail/koa-speer-electronics-inc/CF1-4C102J/13537309
 | 5.1k |  | CARBON FILM RESISTOR | KOA Speer Electronics, Inc. | CFS1/4CT52R512J | 0.10000 | https://www.digikey.com/en/products/detail/koa-speer-electronics-inc/CFS1-4CT52R512J/13537320
 |  |  | CARBON FILM RESISTOR | KOA Speer Electronics, Inc. | CFS1/4CT52R512J | 0.10000 | https://www.digikey.com/en/products/detail/koa-speer-electronics-inc/CFS1-4CT52R512J/13537320
 | 12k |  | CARBON FILM RESISTOR | KOA Speer Electronics, Inc. | CF1/4CT52R123J | 0.10000 | https://www.digikey.com/en/products/detail/koa-speer-electronics-inc/CF1-4CT52R123J/13537545
 | 560 | 5 Volt Generator | CARBON FILM RESISTOR | KOA Speer Electronics, Inc. | CF1/2CT52R561J | 0.11000 | https://www.digikey.com/en/products/detail/koa-speer-electronics-inc/CF1-2CT52R561J/13537660
 | 2.7k |  | CARBON FILM RESISTOR | KOA Speer Electronics, Inc. | CF1/2CT52R272J | 0.11000 | https://www.digikey.com/en/products/detail/koa-speer-electronics-inc/CF1-2CT52R272J/13537283
 | 5.1k |  | CARBON FILM RESISTOR | KOA Speer Electronics, Inc. | CFS1/4CT52R512J | 0.10000 | https://www.digikey.com/en/products/detail/koa-speer-electronics-inc/CFS1-4CT52R512J/13537320
 |  |  | CARBON FILM RESISTOR | KOA Speer Electronics, Inc. | CFS1/4CT52R512J | 0.10000 | https://www.digikey.com/en/products/detail/koa-speer-electronics-inc/CFS1-4CT52R512J/13537320
 | 240 | Amplifier | CARBON FILM RESISTOR | KOA Speer Electronics, Inc. | CF1/2CT52R241J | 0.11000 | https://www.digikey.com/en/products/detail/koa-speer-electronics-inc/CF1-2CT52R241J/13537207
 | 1.2k |  | CARBON FILM RESISTOR | KOA Speer Electronics, Inc. | CF1/4CT52R122J | 0.10000 | https://www.digikey.com/en/products/detail/koa-speer-electronics-inc/CF1-4CT52R122J/13537357
 | 1.2k | Error Amplifier | CARBON FILM RESISTOR | KOA Speer Electronics, Inc. | CF1/4CT52R122J | 0.10000 | https://www.digikey.com/en/products/detail/koa-speer-electronics-inc/CF1-4CT52R122J/13537357
 | 3.3k |  | CARBON FILM RESISTOR | KOA Speer Electronics, Inc. | CF1/4CT52R332J | 0.10000 | https://www.digikey.com/en/products/detail/koa-speer-electronics-inc/CF1-4CT52R332J/13537585
 | 5.1k |  | CARBON FILM RESISTOR | KOA Speer Electronics, Inc. | CFS1/4CT52R512J | 0.10000 | https://www.digikey.com/en/products/detail/koa-speer-electronics-inc/CFS1-4CT52R512J/13537320
 |  |  | CARBON FILM RESISTOR | KOA Speer Electronics, Inc. | CFS1/4CT52R512J | 0.10000 | https://www.digikey.com/en/products/detail/koa-speer-electronics-inc/CFS1-4CT52R512J/13537320
 | 680 | PI Controller | CARBON FILM RESISTOR | KOA Speer Electronics, Inc. | CFS1/4CT52R681J | 0.10000 | https://www.digikey.com/en/products/detail/koa-speer-electronics-inc/CFS1-4CT52R681J/13537187
 | 820 |  | CARBON FILM RESISTOR | KOA Speer Electronics, Inc. | CF1/2CT52R821J | 0.11000 | https://www.digikey.com/en/products/detail/koa-speer-electronics-inc/CF1-2CT52R821J/13537657
 |  |  | CARBON FILM RESISTOR | KOA Speer Electronics, Inc. | CF1/2CT52R821J | 0.11000 | https://www.digikey.com/en/products/detail/koa-speer-electronics-inc/CF1-2CT52R821J/13537657
 | 2.2k |  | CARBON FILM RESISTOR | KOA Speer Electronics, Inc. | CF1/2CT52R222J | 0.11000 | https://www.digikey.com/en/products/detail/koa-speer-electronics-inc/CF1-2CT52R222J/13537296
 |  |  | CARBON FILM RESISTOR | KOA Speer Electronics, Inc. | CF1/2CT52R222J | 0.11000 | https://www.digikey.com/en/products/detail/koa-speer-electronics-inc/CF1-2CT52R222J/13537296
 | 5.6k |  | CARBON FILM RESISTOR | KOA Speer Electronics, Inc. | CF1/4CT52R562J | 0.10000 | https://www.digikey.com/en/products/detail/koa-speer-electronics-inc/CF1-4CT52R562J/13537391
 | 1.2k | Timer | CARBON FILM RESISTOR | KOA Speer Electronics, Inc. | CFS1/4CT52R122J | 0.10000 | https://www.digikey.com/en/products/detail/koa-speer-electronics-inc/CFS1-4CT52R122J/13537176
 | 3.3k |  | CARBON FILM RESISTOR | KOA Speer Electronics, Inc. | CF1/4CT52R332J | 0.10000 | https://www.digikey.com/en/products/detail/koa-speer-electronics-inc/CF1-4CT52R332J/13537585
 | 100k |  | CARBON FILM RESISTOR | KOA Speer Electronics, Inc. | CF1/2CT52R104J | 0.11000 | https://www.digikey.com/en/products/detail/koa-speer-electronics-inc/CF1-2CT52R104J/13537322
Capacitors | 100µF | Buck Converter | Aluminum Electrolytic | Illınois Capacitor | 107RZM05 | 0.02856 | https://www.digikey.com/en/products/detail/illinois-capacitor/107RZM050M/5410782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
 | 100µF | Filter | Aluminum Electrolytic | United Chemi-Con | EKXJ221ELL101MK25S (https://www.digikey.com/en/products/detail/united-chemi-con/EKXJ221ELL101MK25S/3528962) | 0.71258 | https://www.digikey.com/en/products/detail/united-chemi-con/EKXJ221ELL101MK25S/3528962
 | 1nF | Timer | Ceramic | Yageo | CC0100KRX5R4BB102 (https://www.digikey.com/en/products/detail/yageo/CC0100KRX5R4BB102/11490370) | 0.01475 | https://www.digikey.com/en/products/detail/yageo/CC0100KRX5R4BB102/11490370
Inductor | 15mH | Buck Converter | Fixed RING CORE CHOKE | EPCOS/TDK | 871-B82724J8302N040 | 5.9593 | https://www.mouser.com.tr/ProductDetail/EPCOS-TDK/B82724J8302N040/?qs=%252BEew9%252B0nqrD0Uzgfxz0lWg%3D%3D
MOSFET | 240V (max), 210V(Rated); 5A (max), 2A (Rated) | Buck Converter | N-MOSFET | Infineon Technologies | 726-IPN70R360P7SAUMA | 0.92964 | https://www.mouser.com.tr/ProductDetail/Infineon-Technologies/IPN70R360P7SAUMA1/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
Diodes |  | Rectifier | Bridge Rectifier | Micro Commercial Components | 833-3GBJ3516-BP | 5.4778 | https://www.mouser.com.tr/ProductDetail/Micro-Commercial-Components-MCC/3GBJ3516-BP/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
 |  | Buck Converter | Schottky Diode | Wolfspeed / Cree | 941-C6D04065E | 0.89914 | https://www.mouser.com.tr/ProductDetail/Wolfspeed-Cree/C6D04065E/
 |  | Before the battery | Schottky Diode | Vishay General Semiconductor | 78-V8PAM10S-M3/H | 0.4026 | https://www.mouser.com.tr/ProductDetail/Vishay-General-Semiconductor/V8PAM10S-M3-H/
 |  | Timer | IC OSC SINGLE TIMER | Texas Instruments | 296-1857-5-ND | 0.84 | https://www.digikey.com/en/products/detail/texas-instruments/TLC555CP/277502
OP-AMP(2) |  | 4xOP-AMP | LM324 QUADRUPLE OP-AMP | Texas Instruments | 595-LM324KADR | 0.432 | https://www.mouser.com.tr/ProductDetail/Texas-Instruments/LM324KADR/?qs=VBduBm9rCJTXl7yYZ%252BbdmQ%3D%3D
OP-AMP (2) |  | Everywhere:) | Operational-Amplifier | NJR | 513-NJU7067M-TE2 | 1.62382 | https://www.mouser.com.tr/ProductDetail/NJR/NJU7067M-TE2/?qs=rkhjVJ6%2F3ELJ%252B9hm5ecd1w%3D%3D
OP-AMP |  | Current Sense | Operational-Amplifier | Texas Instruments | 595-OPA2990IDDFR | 1.6592 | https://www.mouser.com.tr/ProductDetail/Texas-Instruments/OPA2990IDDFR/?qs=sPbYRqrBIVl8X1kiO6ZSPg%3D%3D
 |  |  |  |  | Total Cost = | 18.54739

Sheet: Sayfa2
 | Model | Cost ($) | Reason
Possible Capacitors for Buck | UHE101MED | 0.32
 | 107RZM05 | 0.02856 | Cheaper than others , ripple factor is better than ECA also endurance performance is good enough and low ESR
 | ECA-1M-101B | 0.05607
 | Model | Cost ($) | Reason
Possible Capacitors for Filtering | 107TXK250M (https://www.digikey.com/en/products/detail/illinois-capacitor/107TXK250M/5410817) | 0.79043
 | EKXJ221ELL101MK25S (https://www.digikey.com/en/products/detail/united-chemi-con/EKXJ221ELL101MK25S/3528962) | 0.71258 | Cheaper and smaller size
