EnesCanbolat/EE463-Project/pcb design/User Library-ML8G.STEP

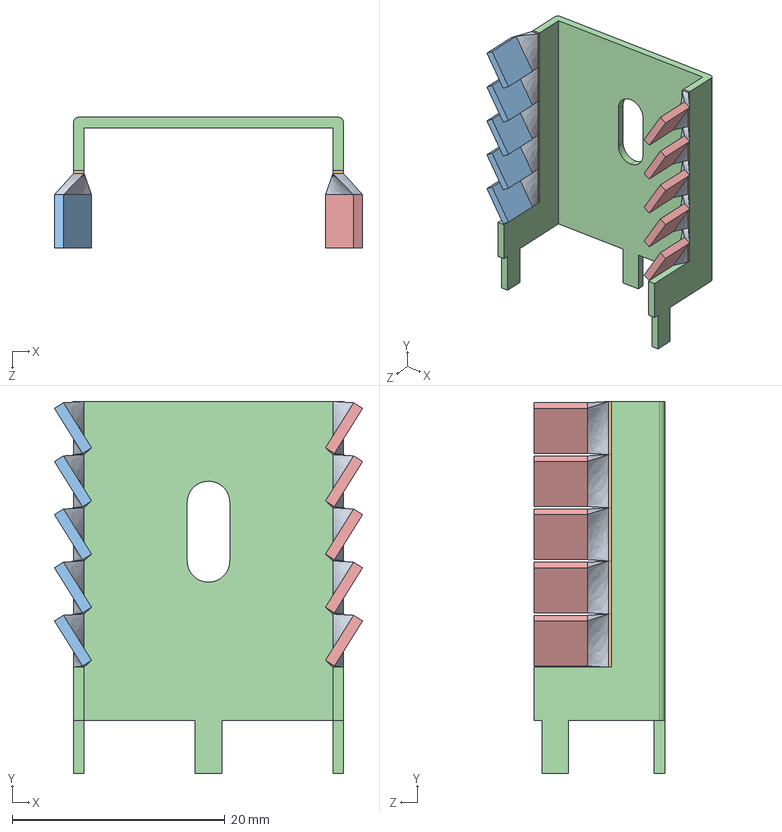
[picture p94: CAD file, 2021-01-14]
pcb design/User Library-ML8G.STEP
29.0 x 35.0 x 12.3 mm
ML8G
ML8G_2
ML8G_3
ML8G_4
ML8G_5
ML8G_6
ML8G_7
ML8G_8
ML8G_9
ML8G_10
ML8G_11
ML8G_12
ML8G_13
ML8G_14
ML8G_15
ML8G_16
ML8G_17
ML8G_18
ML8G_19
ML8G_20
ML8G_21
ML8G_22
ML8G_23
ML8G_24
ML8G_25
ML8G_26
ML8G_27
ML8G_28
ML8G_29
ML8G_30
ML8G_31
