EnesCanbolat/EE463-Project/pcb design/TR Fastenings Ltd-M2_5X6mm.STEP

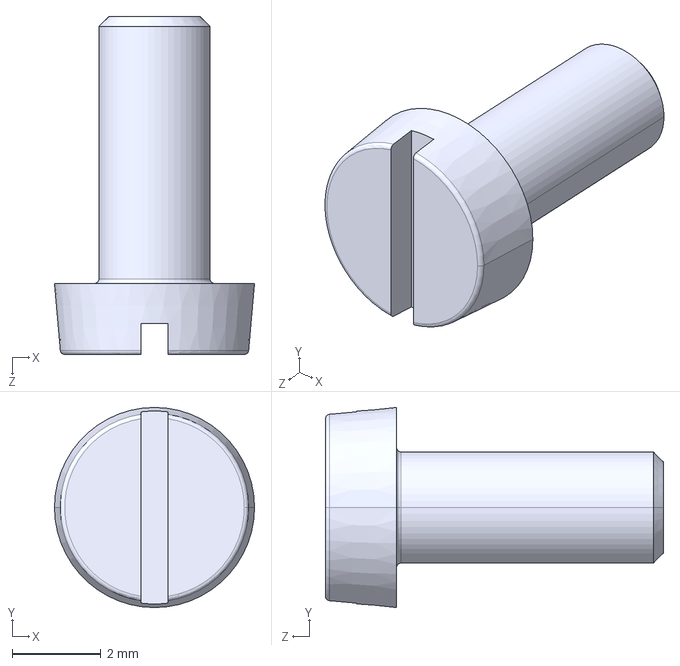
[picture p95: CAD file, 2021-01-14]
pcb design/TR Fastenings Ltd-M2_5X6mm.STEP
4.50 x 4.50 x 7.60 mm
