EnesCanbolat/EE463-Project/(commit log)

2020-11-29 Diode rectifier circuit is completed.
2020-12-12 Buck converter added with Emin and Berkay
2020-12-16 Capacitor and inductor values are changed.
2020-12-19 Strted to design current sense circuit with Berkay & Emin
2020-12-23 Some simulation results for component selection and fourt version of the our design circuit are available.
2020-12-23 Component Selection Table
    [Component List.xlsx]
2020-12-23 Websites of the components are added
    [Component List.xlsx]
2020-12-23 New components are added.
    [Component List.v2.xlsx]
2020-12-23 Component selection finished.
    [Component List.v3.xlsx]
2020-12-24 Schematic of our design circuit is done.
2020-12-24 Topology Selection and Circuit Design parts are finished
2020-12-24 Small Changes
    [Component List.v3.xlsx]
2020-12-24 Circuit Blocks
2020-12-24 The component selection part of the report is over and the component list has been arranged.
    [Component List.v4.xlsx]
2020-12-24 Realistic version of our designed circuit .
2020-12-25 Report is finished after grammerly and some estetic touches :) Also I moved them into Report Versions folder
    [Component List.v4.xlsx]
2021-01-09 Component list is updated.
    [Component List.v5.xlsx]
2021-01-14 pcb design is completed.
    [TR Fastenings Ltd-M2_5X6mm.STEP, User Library-ML8G.STEP]
2021-01-14 Heatsink selection and thermal design analysis have been done
2021-01-14 Datasheet of the selected MOSFET
2021-01-14 PCB design steps have been typed
2021-01-14 1st of the final versions.
    [Component List.xlsx]
2021-01-15 Updated Cost Analysis Table
    [Cost Analysis.xlsx]
